rafaelandrepedro/LPI2-PI-Solar-Tracker/Projecto Integrador LPI 1 fase0_LL.pdf

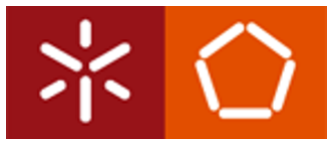
[picture p1: figure]

# PROJETO INTEGRADOR – LPI 1

# SOLAR TRACKER

## UNIVERSIDADE DO MINHO

## MIEEIC - 2020/2021

CONSTITUIÇÃO DO GRUPO:

- Gabriel Barbosa - A88300
- João Paulo - A88273
- Marco Barbosa - A88225
- Rafael Pedro - A88271
- Rodrigo Sousa - A88246
- Tiago Rodrigues - A93792

ORIENTADOR:

- Luís Filipe Castro Freitas Louro

DESCRIÇÃO PROJETO:

Depois de revisto, e aprovado pelo nosso professor orientador, o que se pretende com este projeto é desenvolver um sistema de um painel solar que seja capaz de acompanhar o ciclo solar de forma a retirar o maior proveito do mesmo. Este será capaz de se orientar segundo os dois eixos radiais (azimute e elevação) e terá como entrada a luminosidade exterior, orientando-se no sentido de maior intensidade.

Para o efeito recorrer-se-á a dois motores com alimentação DC e sensibilização para sabermos para que posição o nosso painel se deve deslocar.

Com este sistema espera-se obter um maior rendimento do painel solar, uma vez que este tenderá a apontar para a fonte solar com um ângulo de incidência próximo de zero, aproveitando assim toda a sua área de superfície.
