rafaelandrepedro/LPI2-PI-Solar-Tracker/base medidas (imagem)2.png

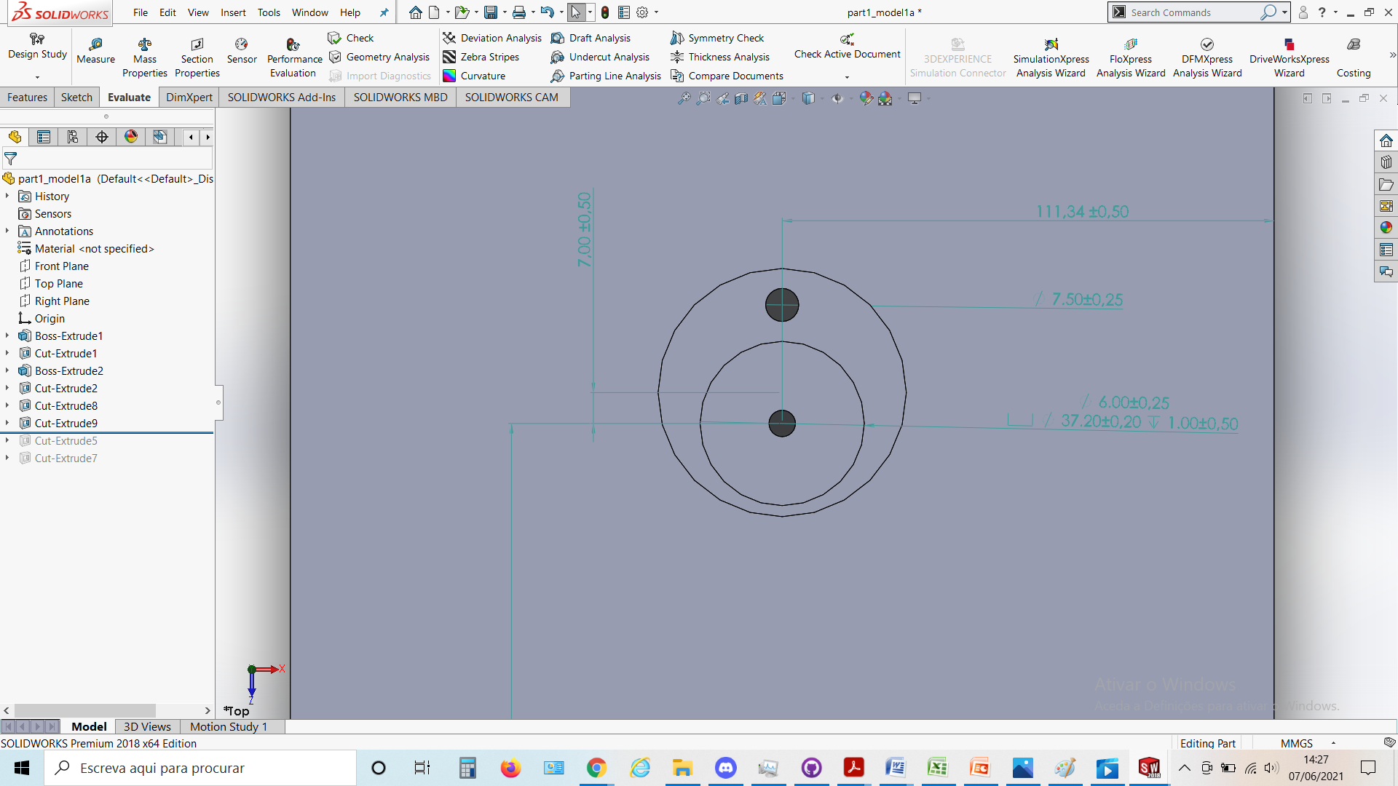
base medidas (imagem)2.png
