rafaelandrepedro/LPI2-PI-Solar-Tracker/base medidas (imagem)3.png

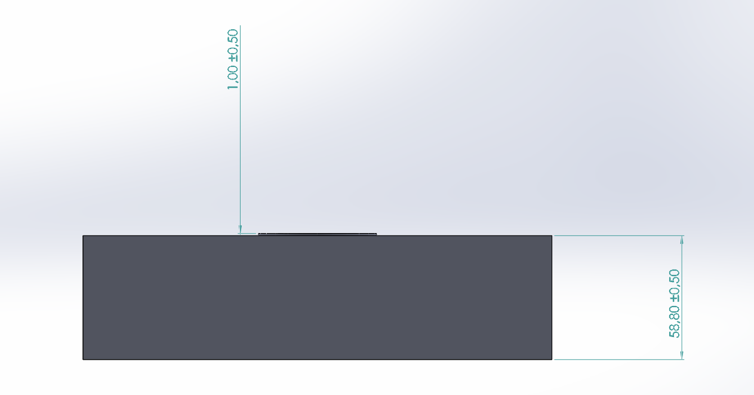
base medidas (imagem)3.png
