rafaelandrepedro/LPI2-PI-Solar-Tracker/base medidas (imagem)4.png

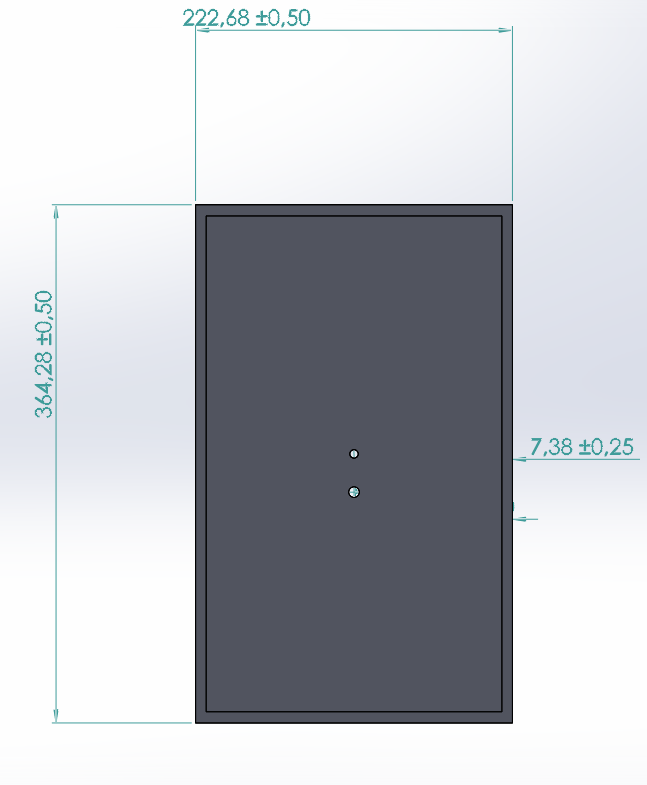
base medidas (imagem)4.png
