rafaelandrepedro/LPI2-PI-Solar-Tracker/base medidas (imagem)5.png

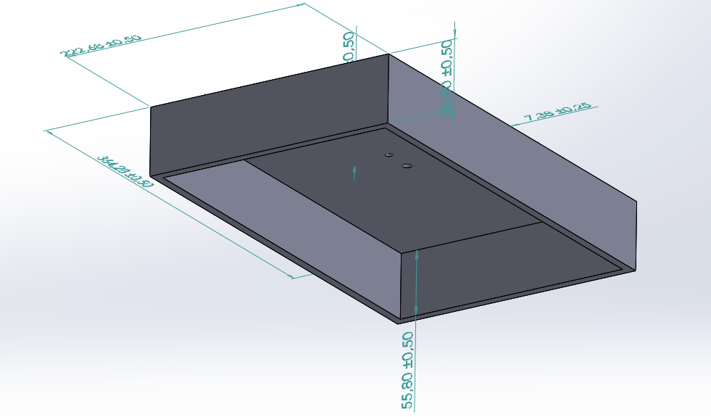
base medidas (imagem)5.png
