rafaelandrepedro/LPI2-PI-Solar-Tracker/base medidas (imagem).png

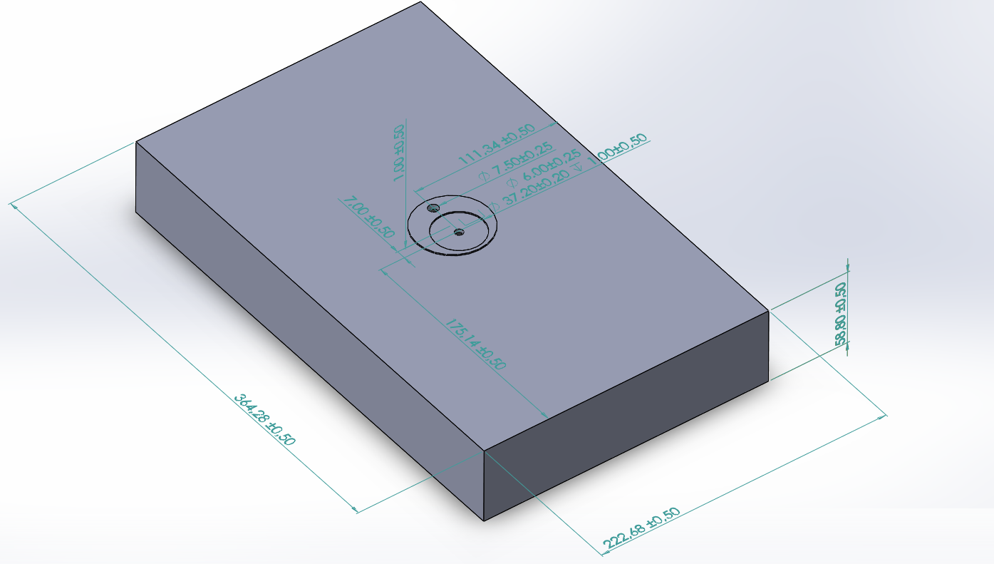
base medidas (imagem).png
