rafaelandrepedro/LPI2-PI-Solar-Tracker/fluxograma2.jpg

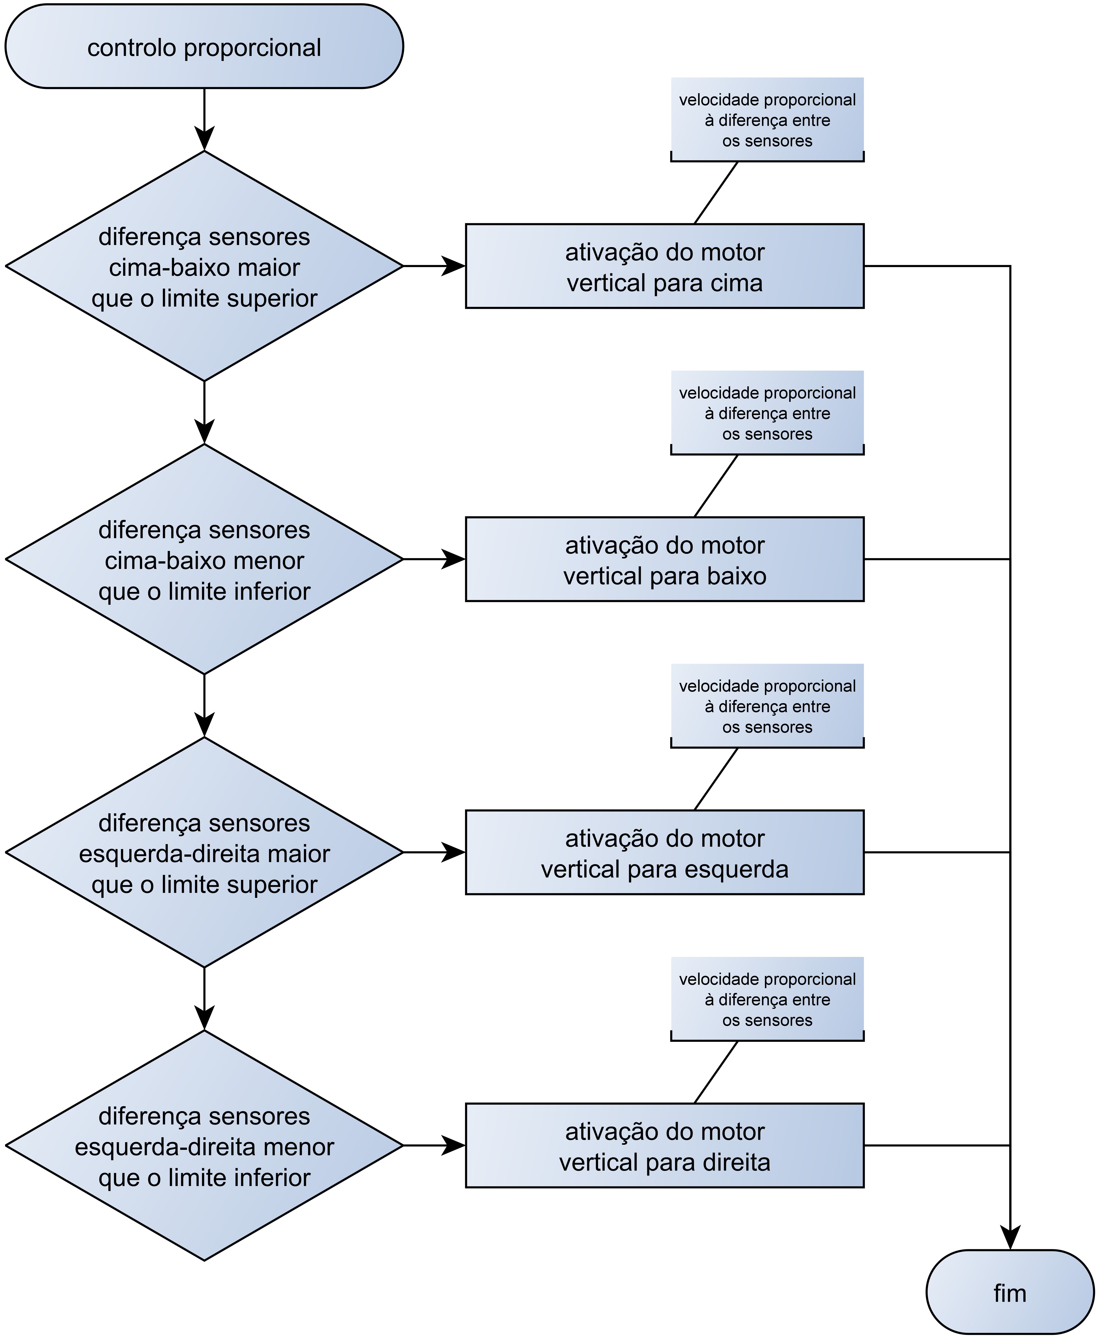
fluxograma2.jpg
