rafaelandrepedro/LPI2-PI-Solar-Tracker/fluxograma.jpg

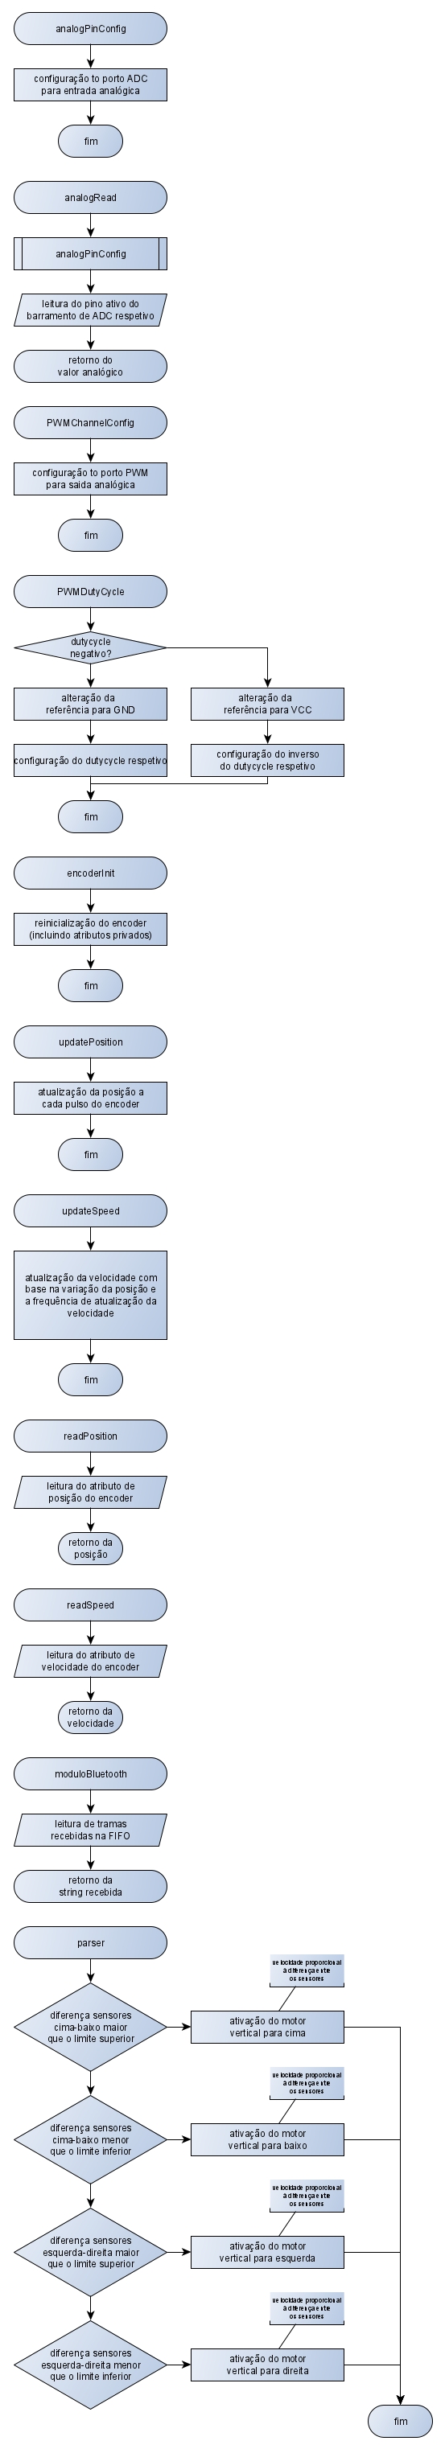
fluxograma.jpg
