rafaelandrepedro/LPI2-PI-Solar-Tracker/painel medidas (imagem)1.png

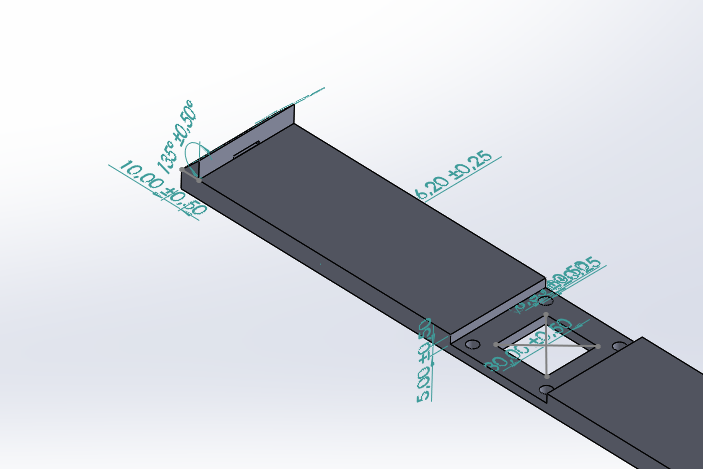
painel medidas (imagem)1.png
