rafaelandrepedro/LPI2-PI-Solar-Tracker/painel medidas (imagem)2.png

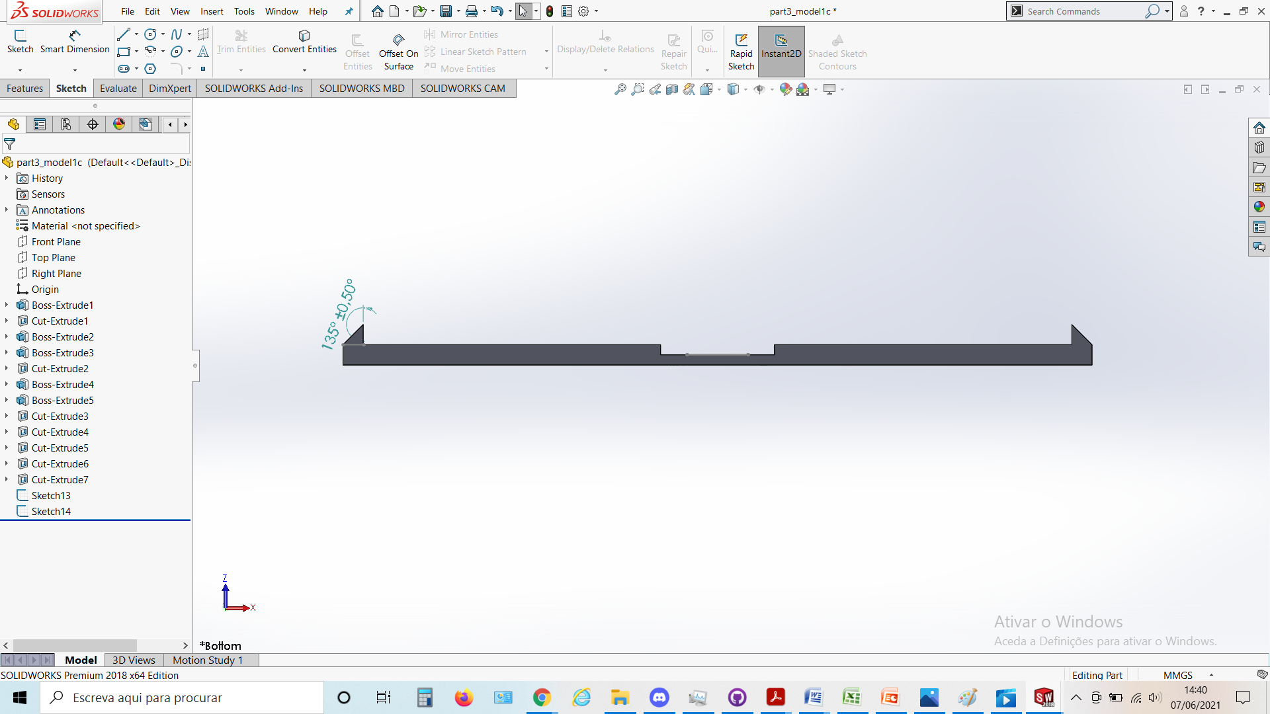
painel medidas (imagem)2.png
