rafaelandrepedro/LPI2-PI-Solar-Tracker/painel medidas (imagem)3.png

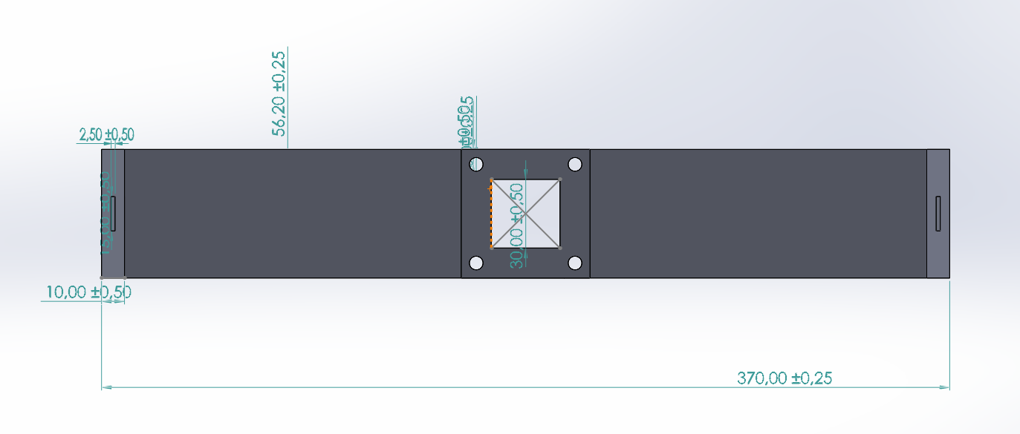
painel medidas (imagem)3.png
