rafaelandrepedro/LPI2-PI-Solar-Tracker/painel medidas (imagem)4.png

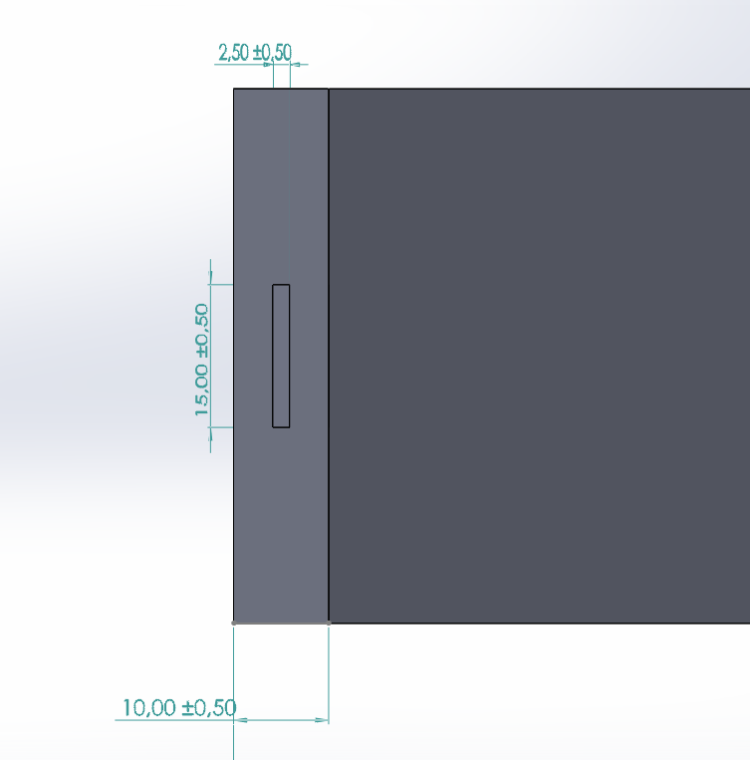
painel medidas (imagem)4.png
