rafaelandrepedro/LPI2-PI-Solar-Tracker/painel medidas (imagem)5.png

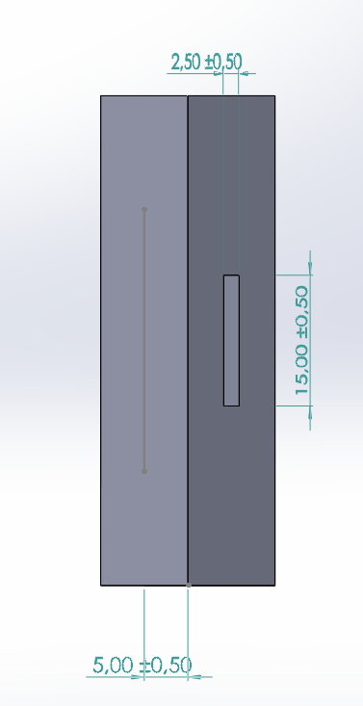
painel medidas (imagem)5.png
