rafaelandrepedro/LPI2-PI-Solar-Tracker/painel medidas (imagem)6.png

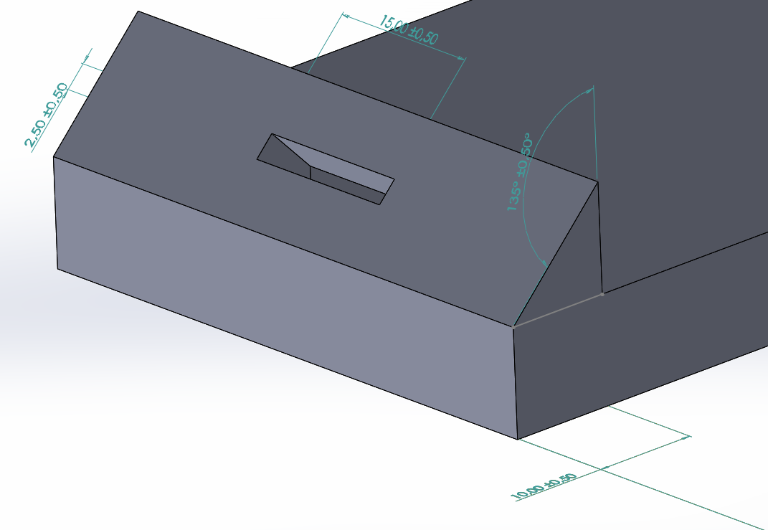
painel medidas (imagem)6.png
