rafaelandrepedro/LPI2-PI-Solar-Tracker/painel medidas (imagem)7.png

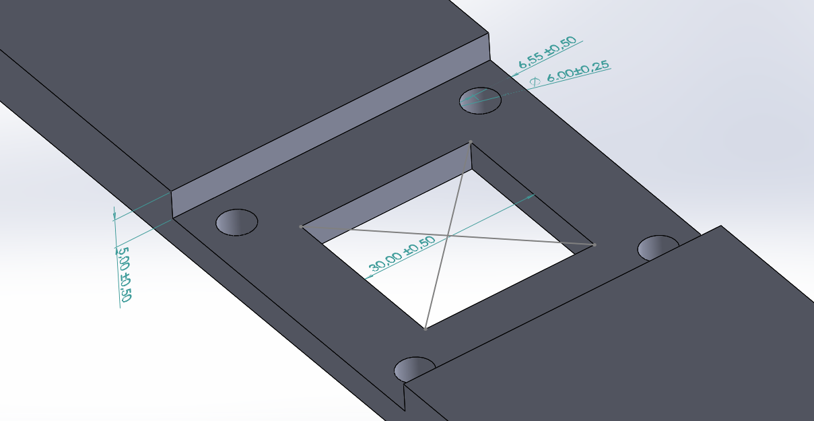
painel medidas (imagem)7.png
