rafaelandrepedro/LPI2-PI-Solar-Tracker/painel medidas (imagem)8.png

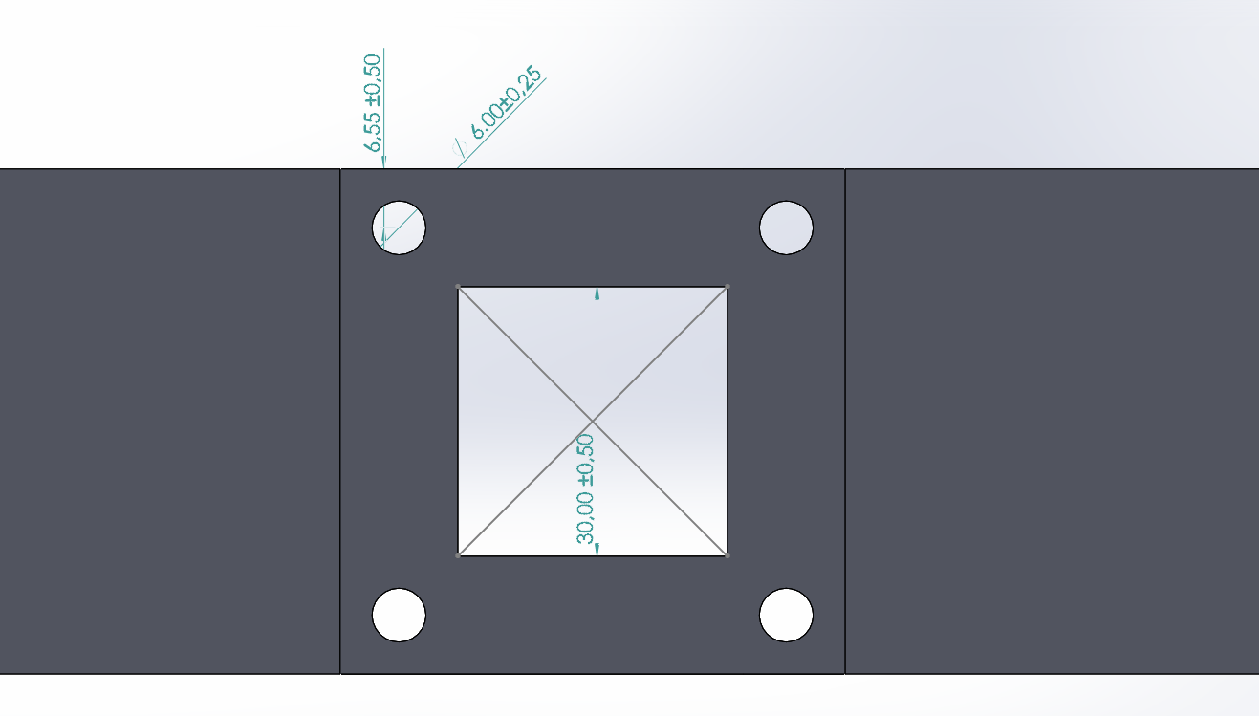
painel medidas (imagem)8.png
