rafaelandrepedro/LPI2-PI-Solar-Tracker/painel medidas (imagem)9.png

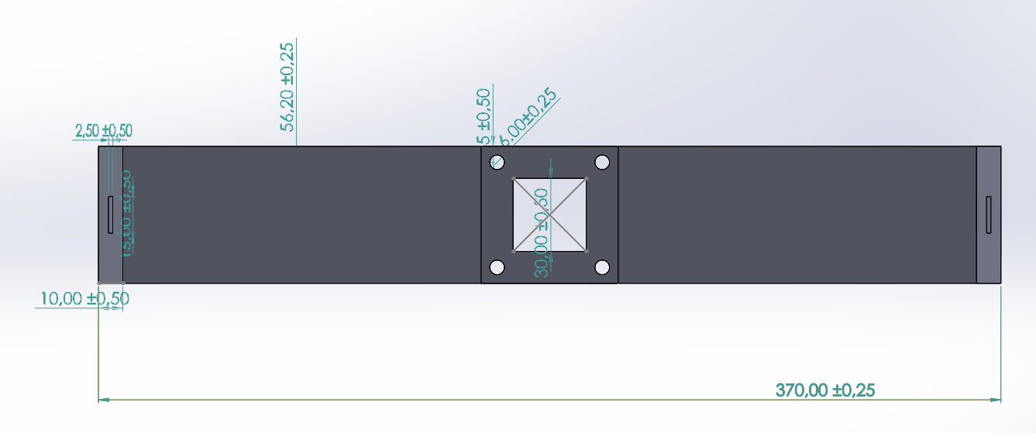
painel medidas (imagem)9.png
