rafaelandrepedro/LPI2-PI-Solar-Tracker/painel medidas (imagem)10.png

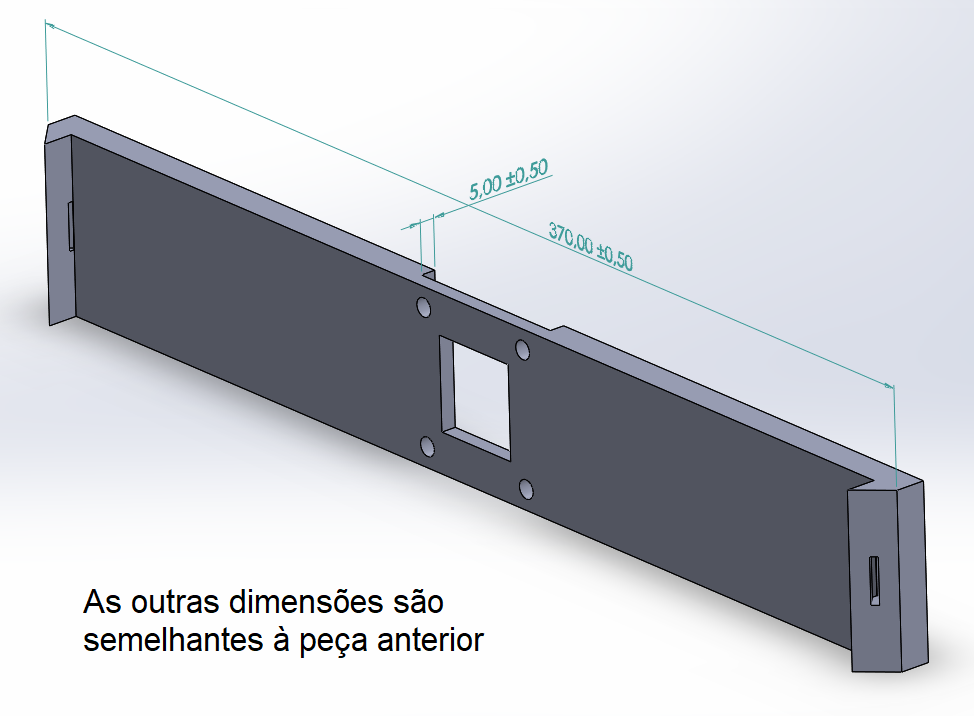
painel medidas (imagem)10.png
