rafaelandrepedro/LPI2-PI-Solar-Tracker/painel medidas (imagem)11.png

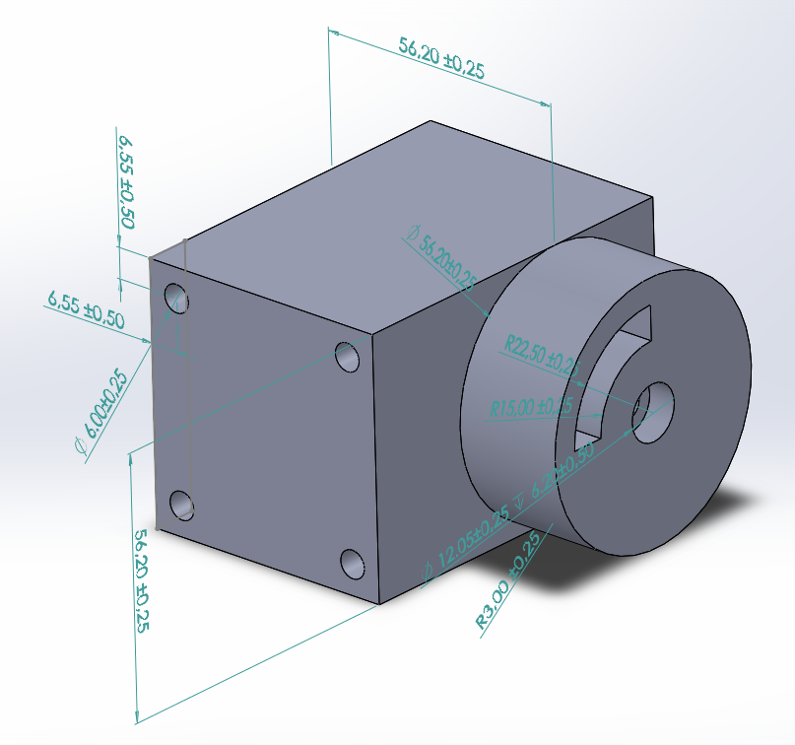
painel medidas (imagem)11.png
