rafaelandrepedro/LPI2-PI-Solar-Tracker/UML.bmp

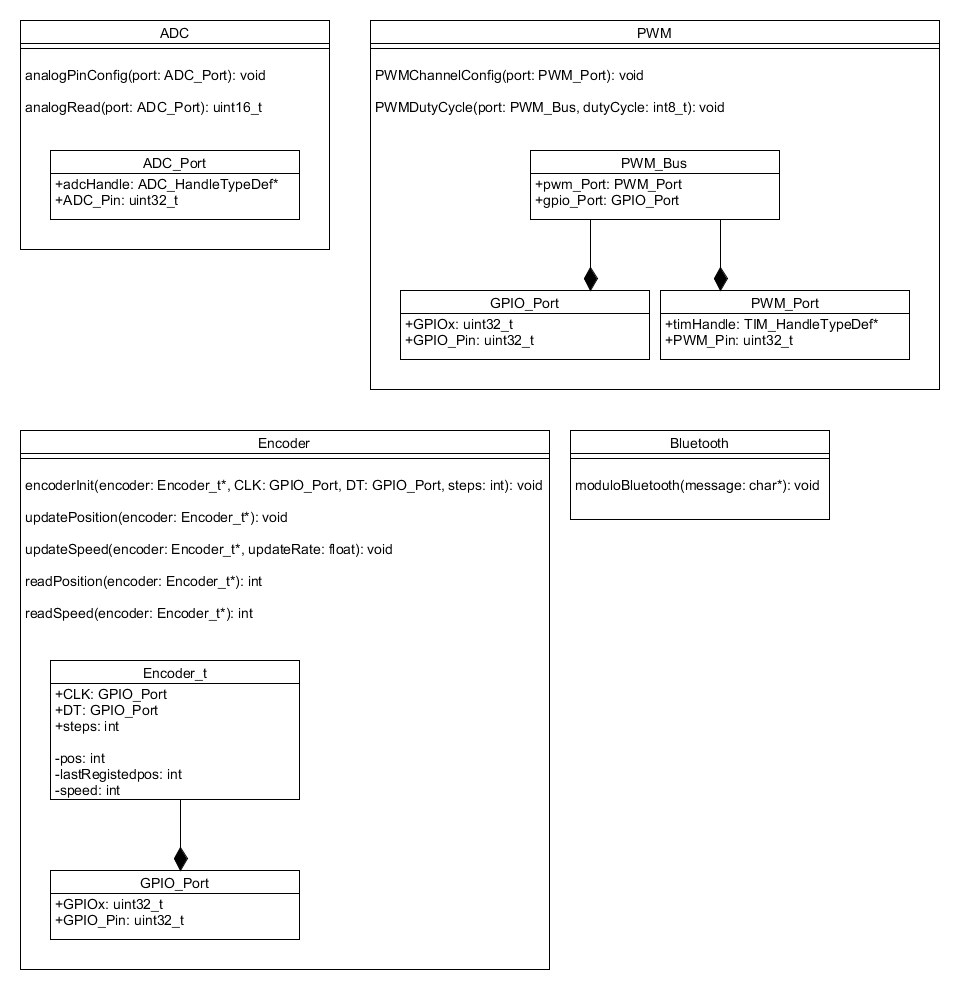
UML.bmp
