rafaelandrepedro/LPI2-PI-Solar-Tracker/UML.jpg

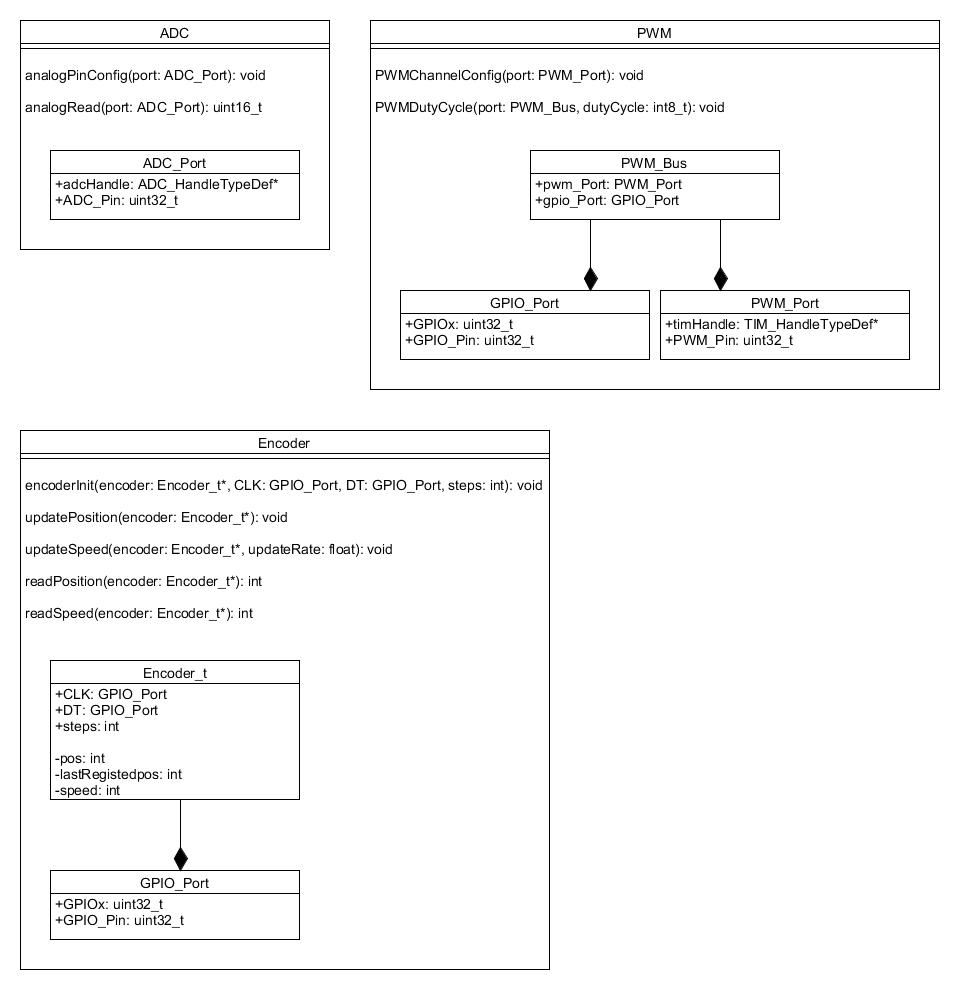
UML.jpg
