rafaelandrepedro/LPI2-PI-Solar-Tracker/modelo novo (com encoder)/Assem1.SLDASM

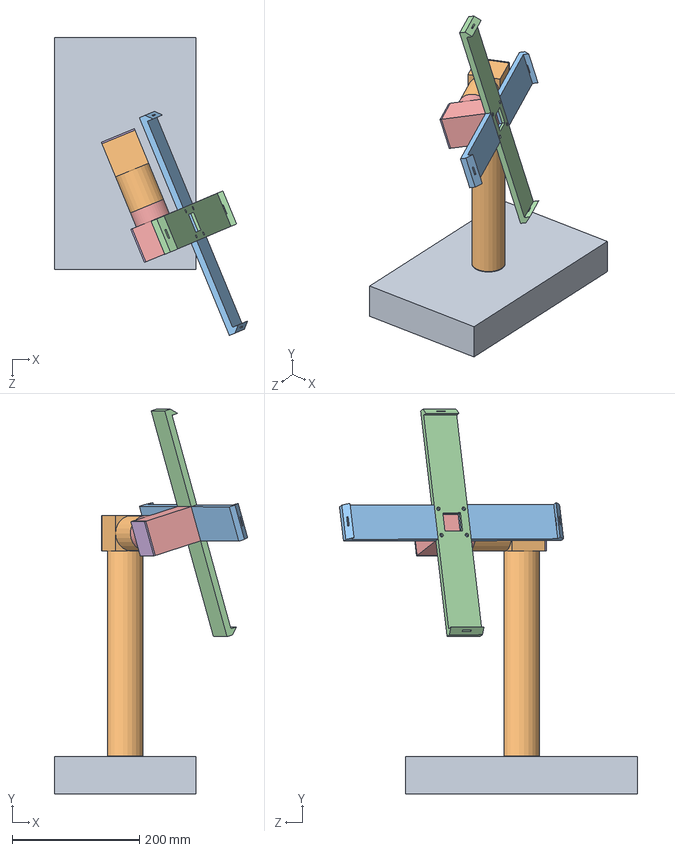
[picture p23: CAD file, 2021-06-18]
modelo novo (com encoder)/Assem1.SLDASM
303.5 x 604.5 x 468.0 mm
part1_model1b
part2_modela
part3_model1c
part3_model1d
part3_model2a
tampa (2) x 2
