rafaelandrepedro/LPI2-PI-Solar-Tracker/ficheiros LPI1/painel solar.SLDASM

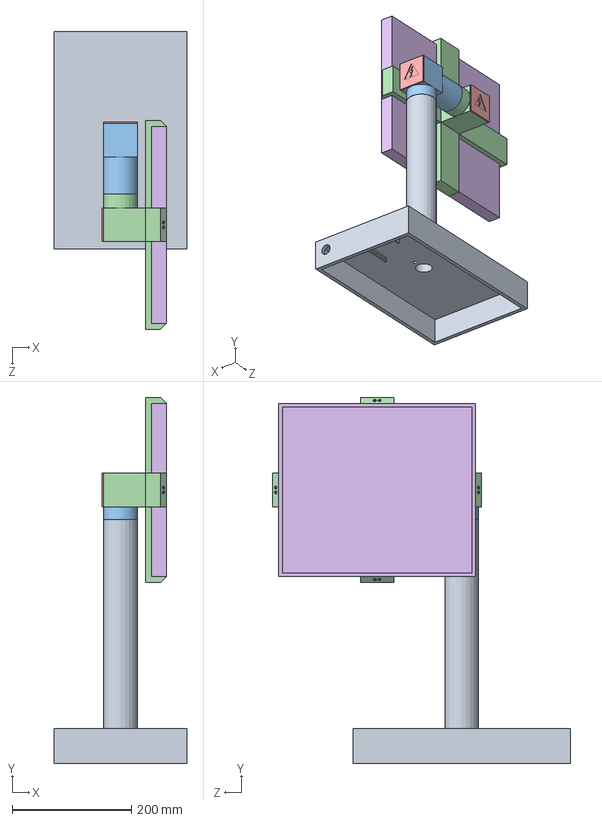
[picture p24: CAD file, 2021-06-05]
ficheiros LPI1/painel solar.SLDASM
222.7 x 613.4 x 498.6 mm
motor x 2
suporte1b
suporte2b
tampa eletrica x 2
PainelSolar
