rafaelandrepedro/LPI2-PI-Solar-Tracker/ficheiros LPI1/Aparelho.SLDASM

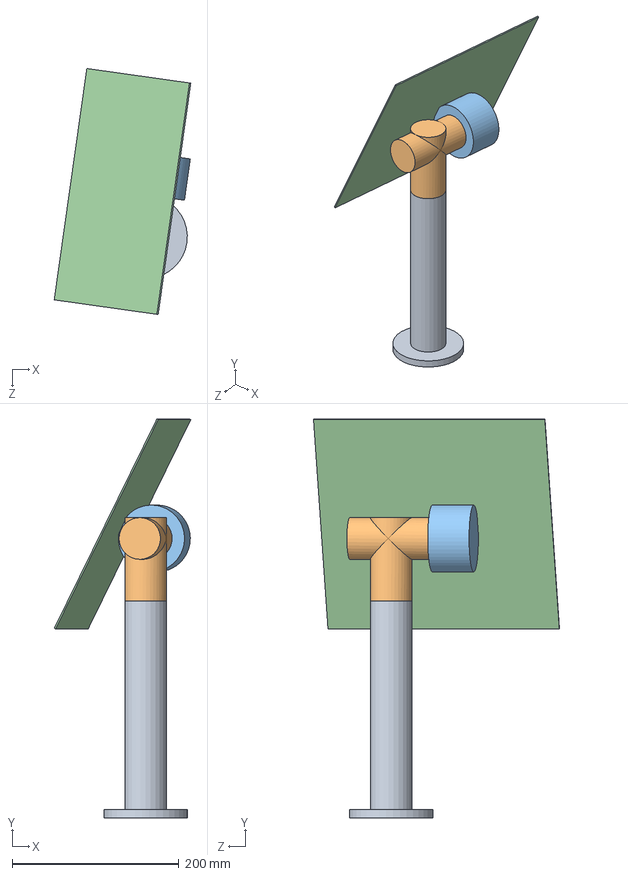
[picture p25: CAD file, 2021-06-05]
ficheiros LPI1/Aparelho.SLDASM
163.7 x 478.2 x 294.8 mm
Parte de baixo
Parte_meio
Parte_cima
PainelSolar
