rafaelandrepedro/LPI2-PI-Solar-Tracker/ficheiros LPI1/tabuleiro.SLDPRT

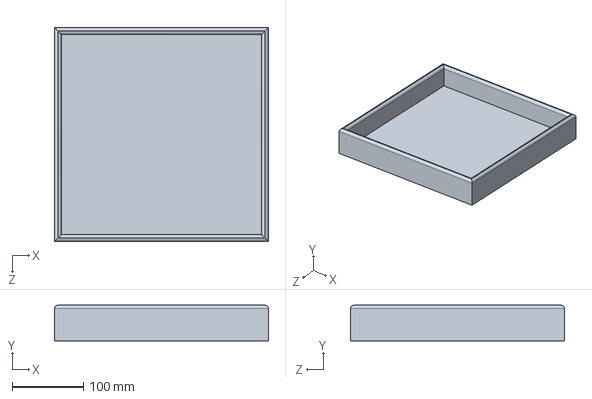
[picture p26: CAD file, 2021-06-05]
ficheiros LPI1/tabuleiro.SLDPRT
300.0 x 50.0 x 300.0 mm
