rafaelandrepedro/LPI2-PI-Solar-Tracker/modelo novo (com encoder)/part1_model1b.SLDPRT

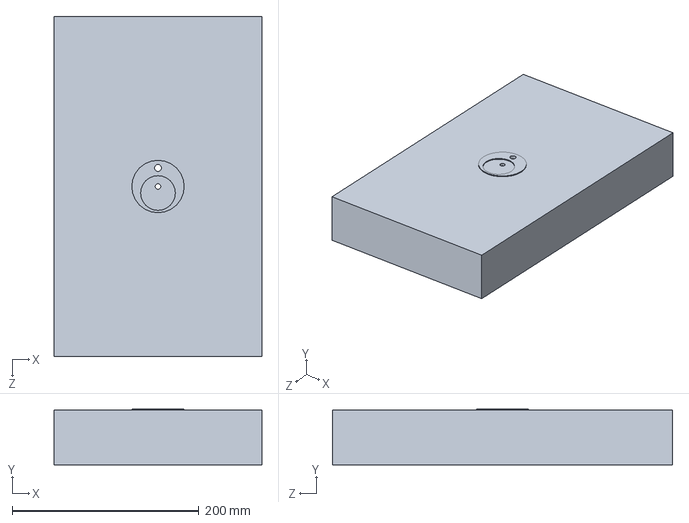
[picture p27: CAD file, 2021-06-18]
modelo novo (com encoder)/part1_model1b.SLDPRT
222.7 x 59.8 x 364.3 mm
