rafaelandrepedro/LPI2-PI-Solar-Tracker/modelo novo (com encoder)/pecas recortadas/base/base1.SLDPRT

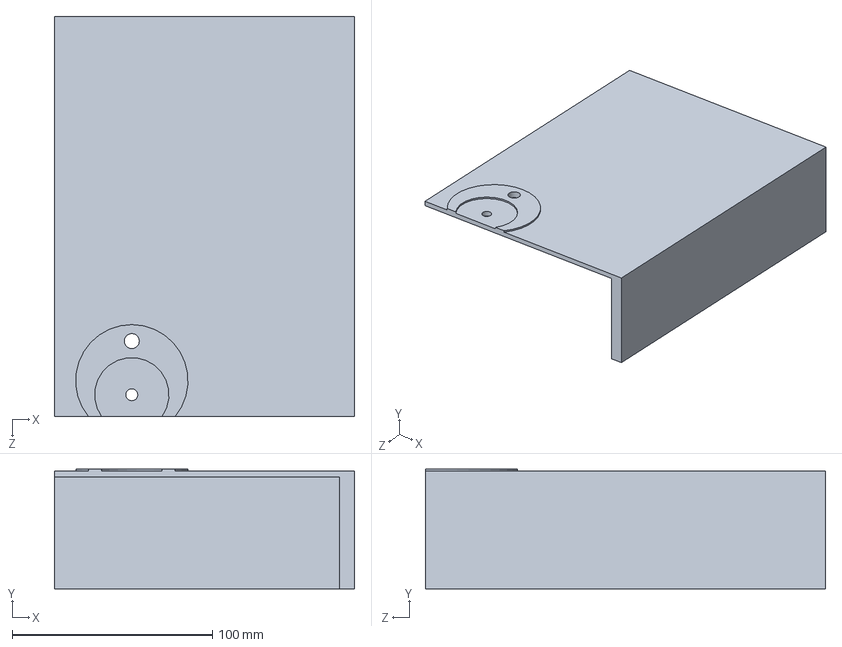
[picture p28: CAD file, 2021-06-14]
modelo novo (com encoder)/pecas recortadas/base/base1.SLDPRT
150.0 x 59.8 x 200.0 mm
