rafaelandrepedro/LPI2-PI-Solar-Tracker/modelo novo (com encoder)/pecas recortadas/cilindros/part2_modela_corte2.SLDPRT

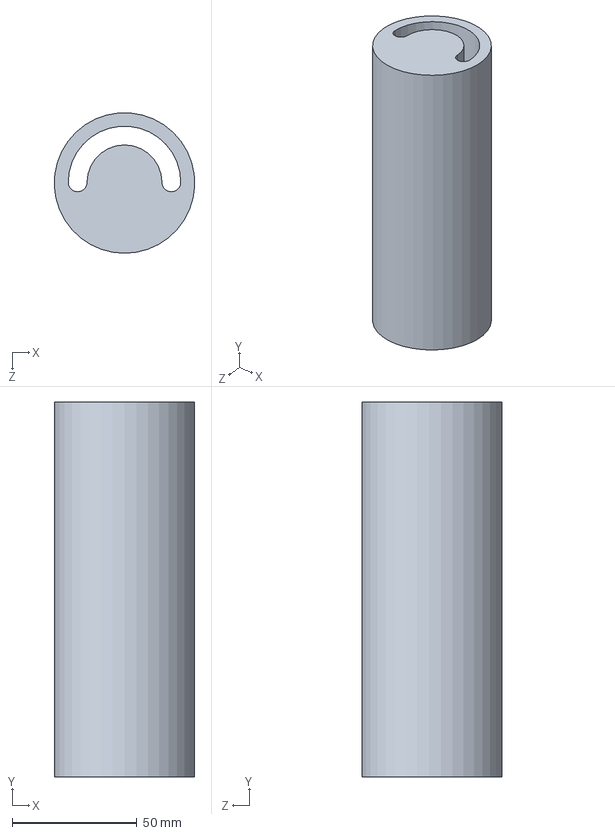
[picture p29: CAD file, 2021-06-10]
modelo novo (com encoder)/pecas recortadas/cilindros/part2_modela_corte2.SLDPRT
56.1 x 150.0 x 56.2 mm
