rafaelandrepedro/LPI2-PI-Solar-Tracker/modelo novo (com encoder)/pecas recortadas/pecas L/part3_model2a.SLDPRT

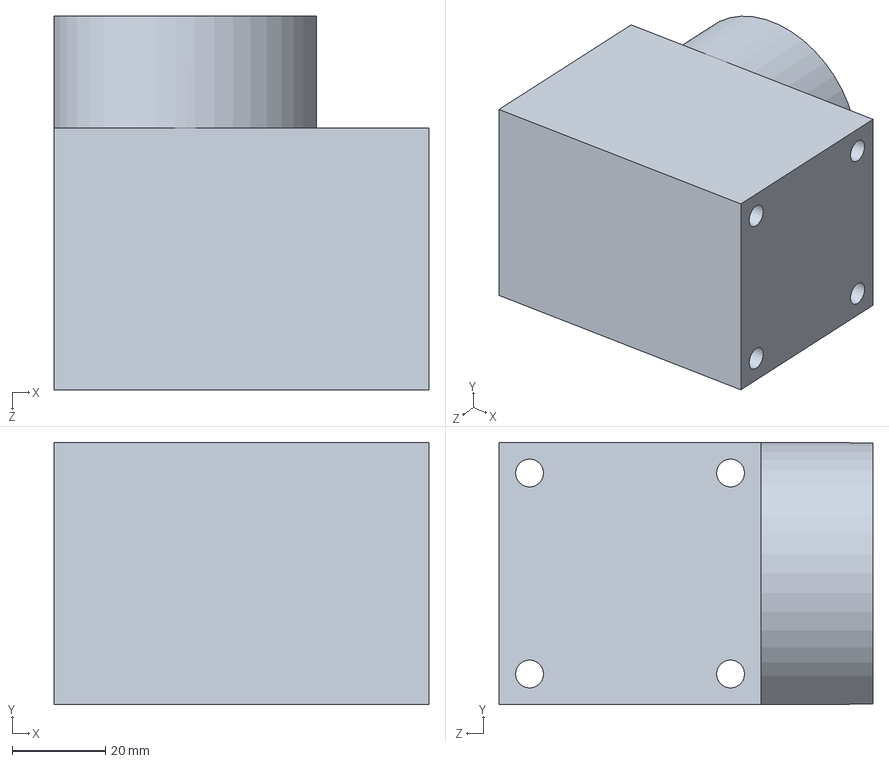
[picture p30: CAD file, 2021-06-10]
modelo novo (com encoder)/pecas recortadas/pecas L/part3_model2a.SLDPRT
80.3 x 56.2 x 80.2 mm
