rafaelandrepedro/LPI2-PI-Solar-Tracker/modelo novo (com encoder)/pecas recortadas/suporte painel/part3_model1_mid_corte (2x).SLDPRT

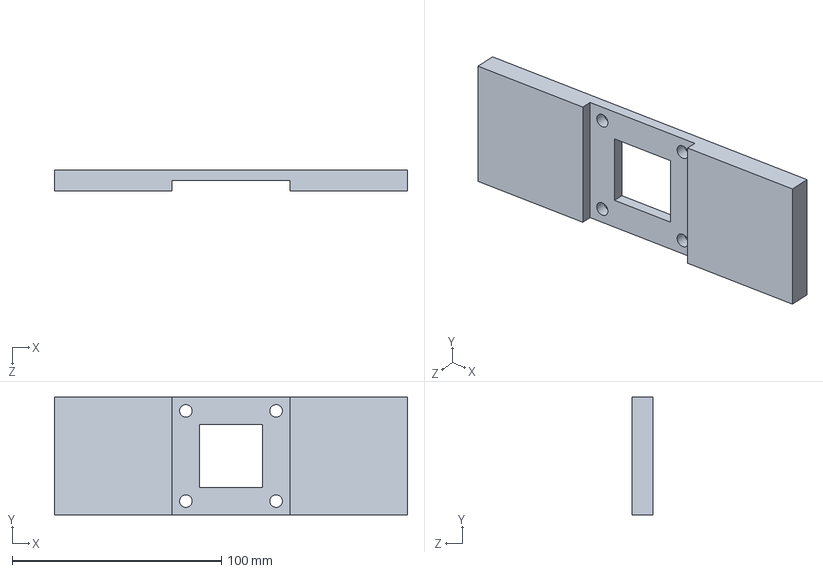
[picture p31: CAD file, 2021-06-10]
modelo novo (com encoder)/pecas recortadas/suporte painel/part3_model1_mid_corte (2x).SLDPRT
168.6 x 56.2 x 10.0 mm
