rafaelandrepedro/LPI2-PI-Solar-Tracker/modelo novo (com encoder)/pecas recortadas/tampa/tampa (2x).SLDPRT

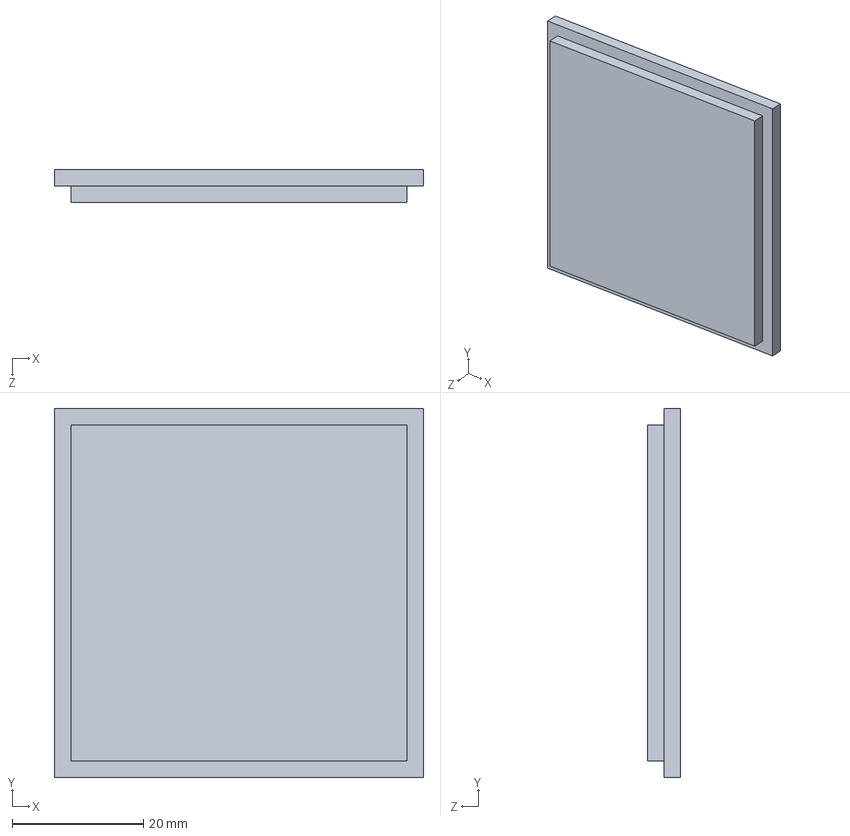
[picture p32: CAD file, 2021-06-05]
modelo novo (com encoder)/pecas recortadas/tampa/tampa (2x).SLDPRT
56.2 x 56.2 x 5.00 mm
