rafaelandrepedro/LPI2-PI-Solar-Tracker/pecas modelo antigo (sem encoder)/suporte1b.SLDPRT

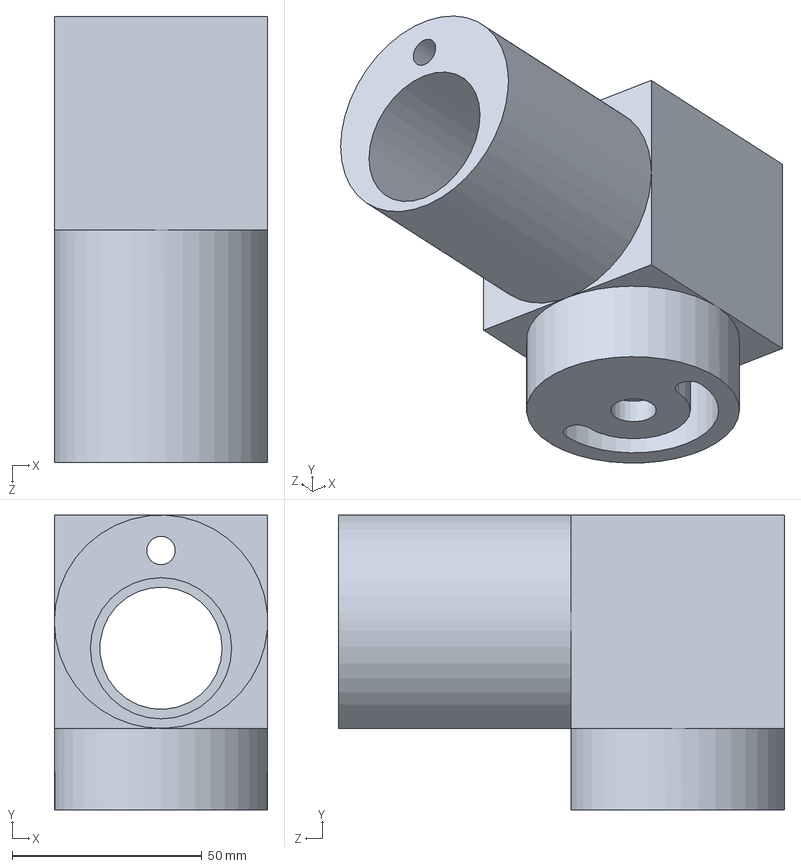
[picture p33: CAD file, 2021-06-05]
pecas modelo antigo (sem encoder)/suporte1b.SLDPRT
56.2 x 77.7 x 117.5 mm
