rafaelandrepedro/LPI2-PI-Solar-Tracker/ficheiros LPI1/Documentação auxiliar/Solid Works/motor.SLDPRT

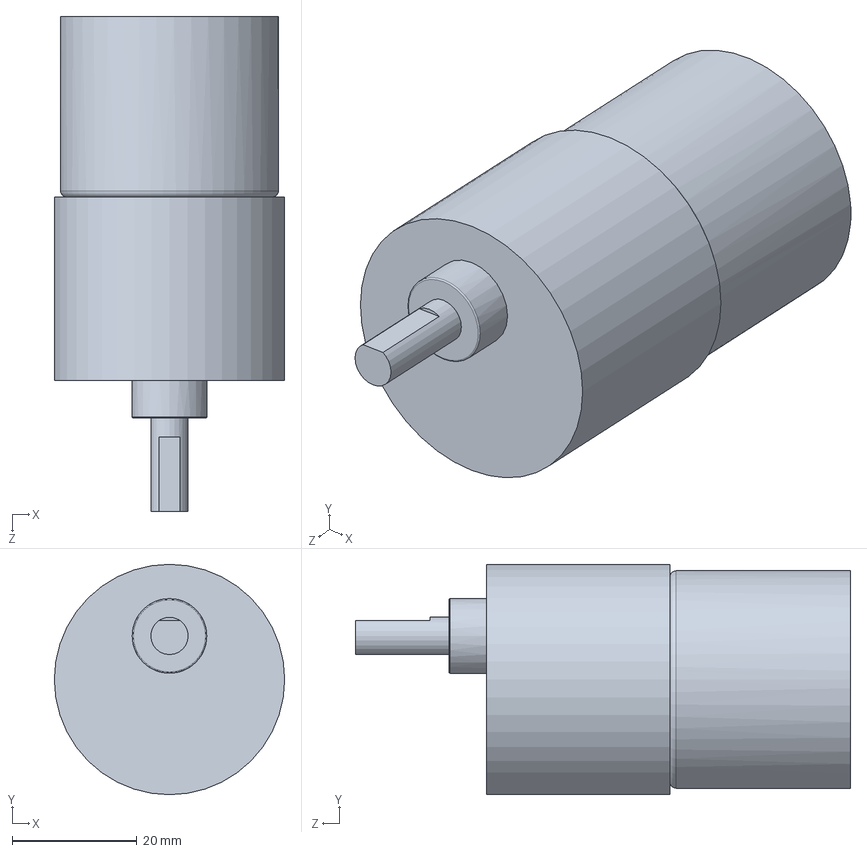
[picture p34: CAD file, 2021-06-05]
ficheiros LPI1/Documentação auxiliar/Solid Works/motor.SLDPRT
37.0 x 37.0 x 79.5 mm
