rafaelandrepedro/LPI2-PI-Solar-Tracker/ficheiros LPI1/peça curva.SLDPRT

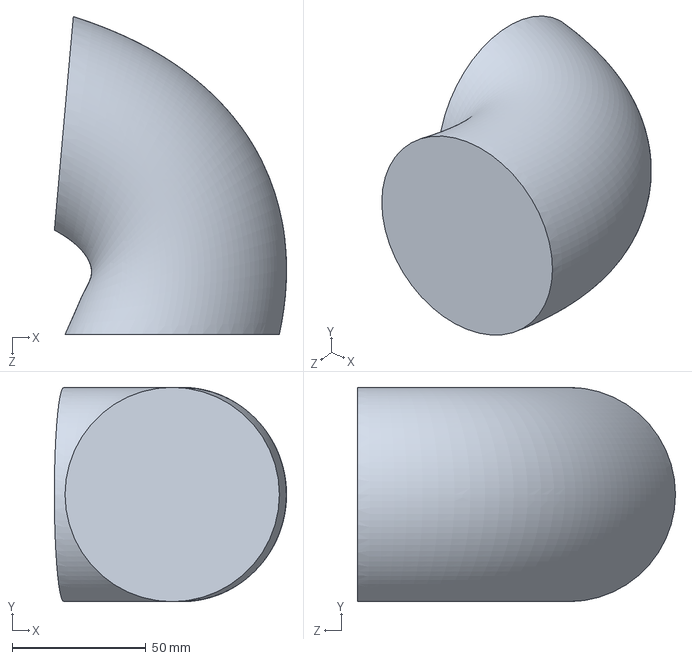
[picture p35: CAD file, 2021-06-05]
ficheiros LPI1/peça curva.SLDPRT
86.7 x 80.0 x 118.7 mm
