rafaelandrepedro/LPI2-PI-Solar-Tracker/modelo novo (com encoder)/pecas recortadas/base/base4.SLDPRT

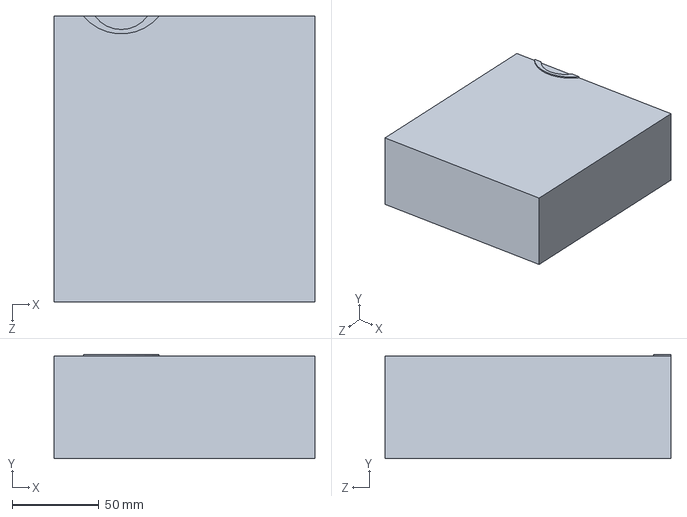
[picture p36: CAD file, 2021-06-14]
modelo novo (com encoder)/pecas recortadas/base/base4.SLDPRT
150.0 x 59.8 x 164.3 mm
