rafaelandrepedro/LPI2-PI-Solar-Tracker/modelo novo (com encoder)/pecas recortadas/cilindros/part2_modela_corte1.SLDPRT

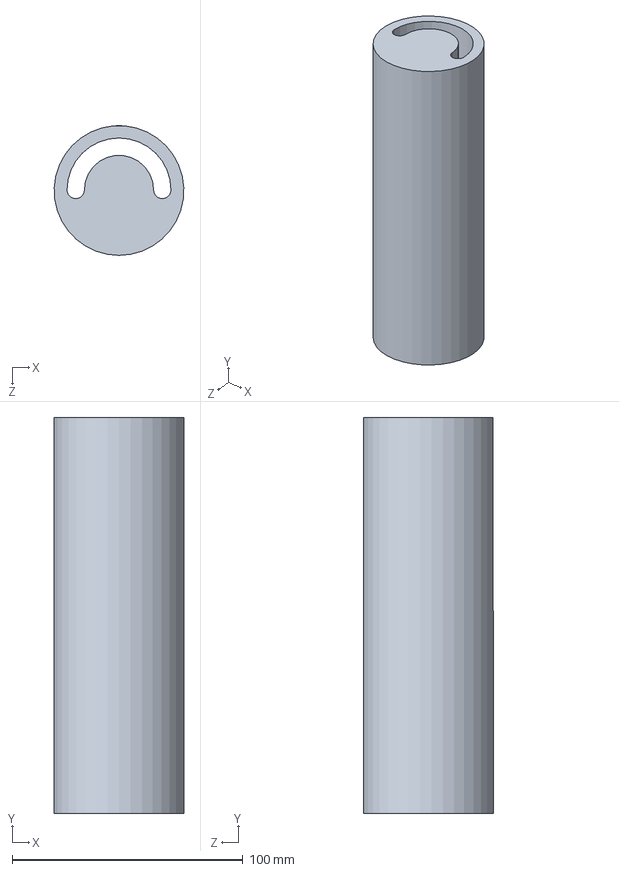
[picture p37: CAD file, 2021-06-10]
modelo novo (com encoder)/pecas recortadas/cilindros/part2_modela_corte1.SLDPRT
56.1 x 171.5 x 56.2 mm
