rafaelandrepedro/LPI2-PI-Solar-Tracker/modelo novo (com encoder)/pecas recortadas/pecas L/part2_modela_corte3.SLDPRT

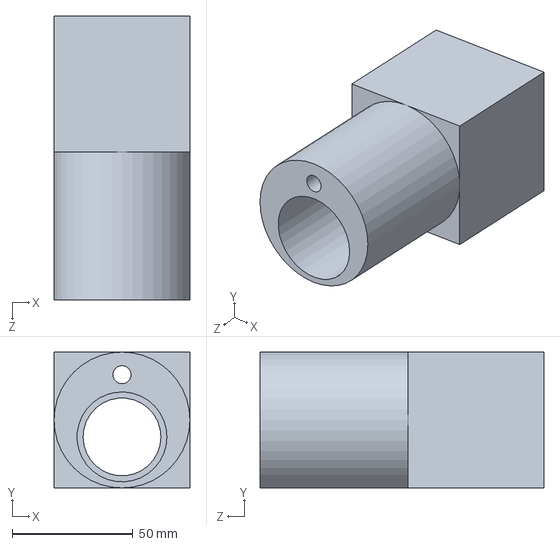
[picture p38: CAD file, 2021-06-10]
modelo novo (com encoder)/pecas recortadas/pecas L/part2_modela_corte3.SLDPRT
56.2 x 56.2 x 117.5 mm
