rafaelandrepedro/LPI2-PI-Solar-Tracker/pecas modelo antigo (sem encoder)/suporte2b.SLDPRT

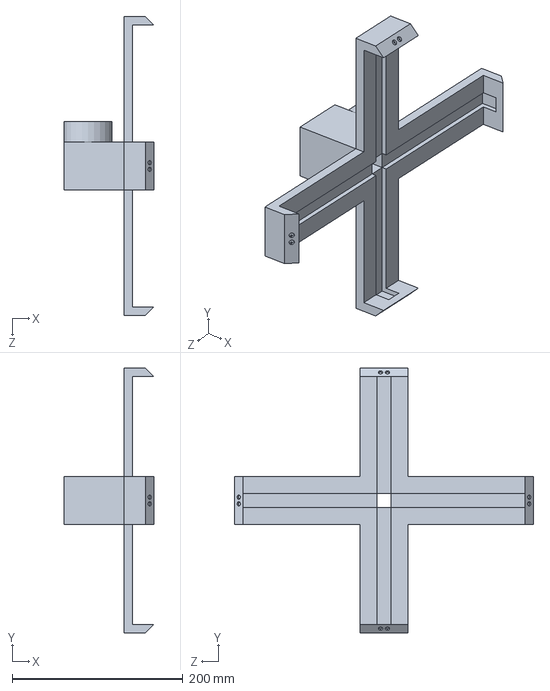
[picture p40: CAD file, 2021-06-05]
pecas modelo antigo (sem encoder)/suporte2b.SLDPRT
105.3 x 310.0 x 350.0 mm
