rafaelandrepedro/LPI2-PI-Solar-Tracker/ficheiros LPI1/Documentação auxiliar/Solid Works/Part1.SLDPRT

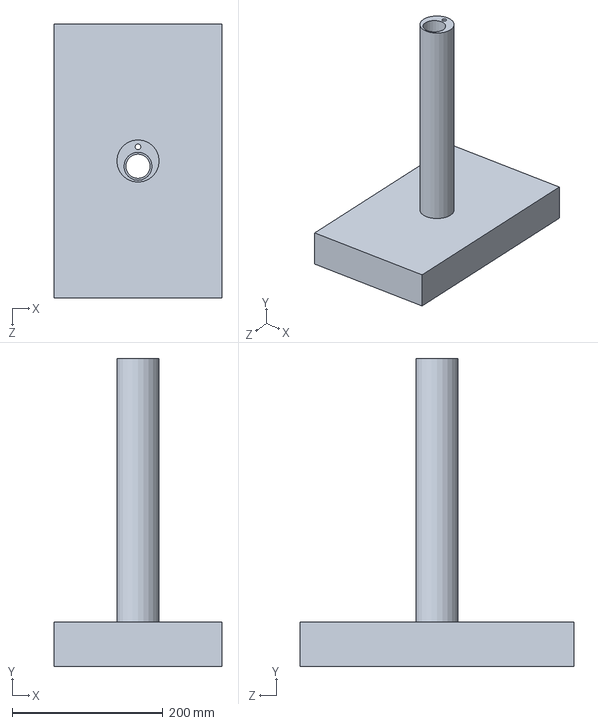
[picture p41: CAD file, 2021-06-05]
ficheiros LPI1/Documentação auxiliar/Solid Works/Part1.SLDPRT
222.7 x 408.8 x 364.3 mm
