rafaelandrepedro/LPI2-PI-Solar-Tracker/modelo novo (com encoder)/part3_model1c.SLDPRT

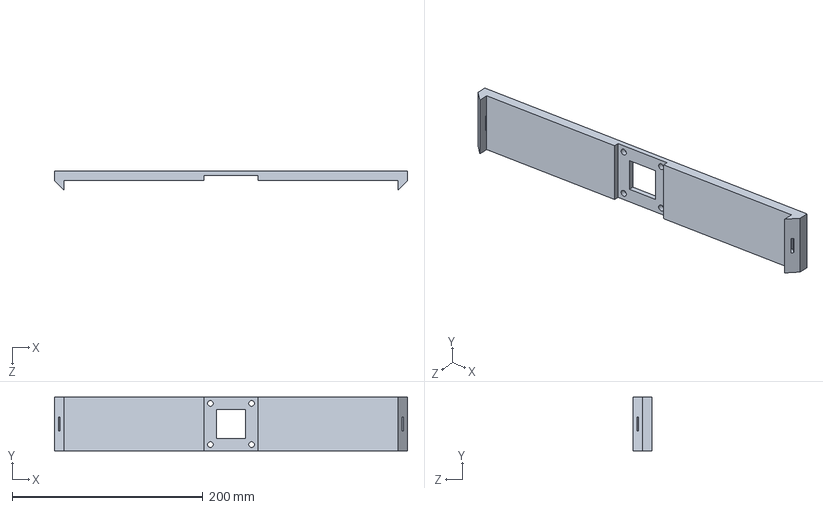
[picture p42: CAD file, 2021-06-18]
modelo novo (com encoder)/part3_model1c.SLDPRT
370.0 x 56.2 x 20.0 mm
