rafaelandrepedro/LPI2-PI-Solar-Tracker/modelo novo (com encoder)/pecas recortadas/base/base2.SLDPRT

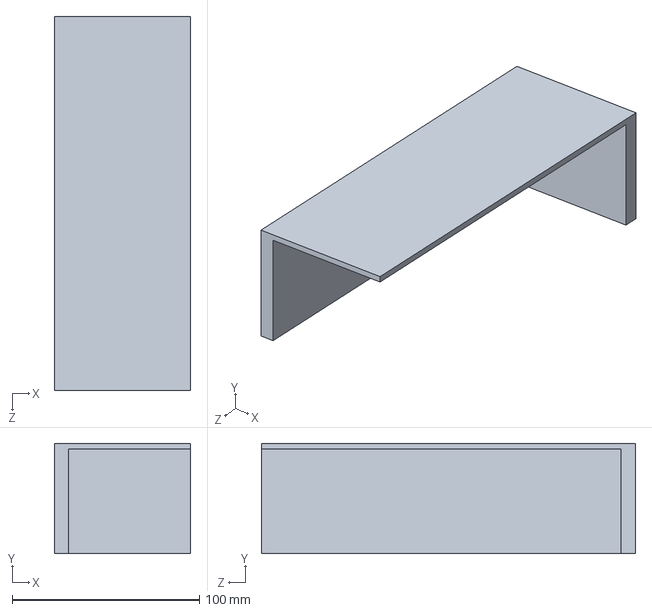
[picture p43: CAD file, 2021-06-14]
modelo novo (com encoder)/pecas recortadas/base/base2.SLDPRT
72.7 x 58.8 x 200.0 mm
