rafaelandrepedro/LPI2-PI-Solar-Tracker/modelo novo (com encoder)/pecas recortadas/suporte painel/part3_model1_top_corte1 (2x).SLDPRT

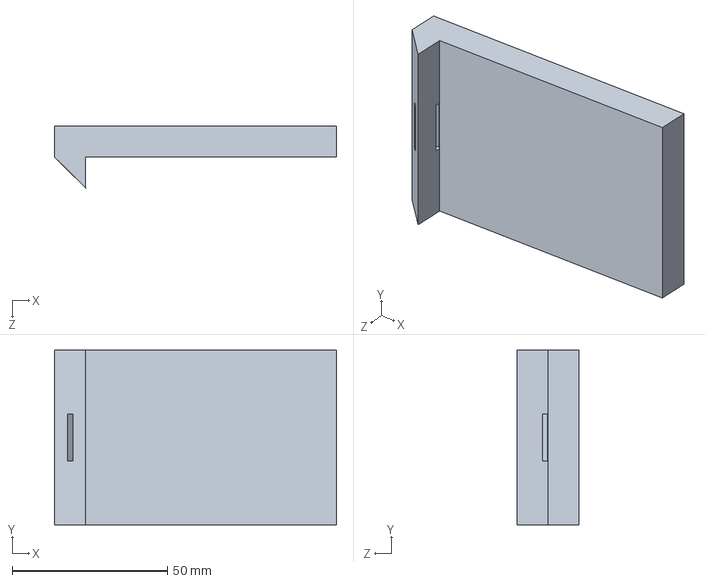
[picture p44: CAD file, 2021-06-10]
modelo novo (com encoder)/pecas recortadas/suporte painel/part3_model1_top_corte1 (2x).SLDPRT
90.7 x 56.2 x 20.0 mm
