rafaelandrepedro/LPI2-PI-Solar-Tracker/pecas modelo antigo (sem encoder)/Part3.SLDPRT

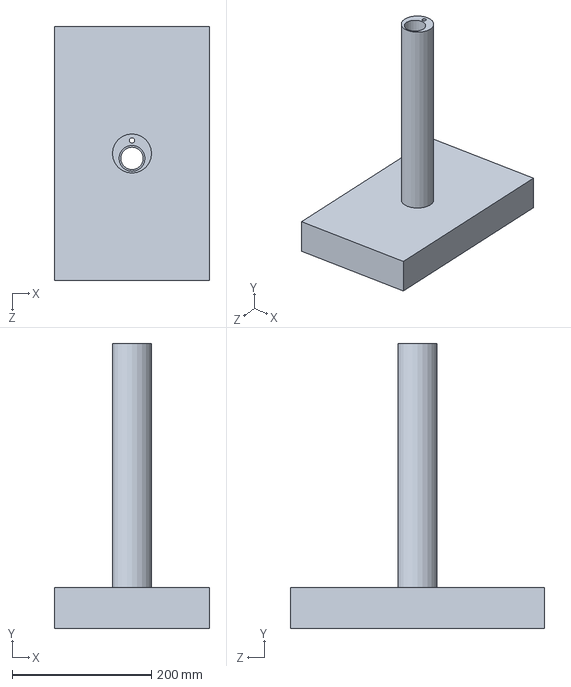
[picture p45: CAD file, 2021-06-05]
pecas modelo antigo (sem encoder)/Part3.SLDPRT
222.7 x 408.8 x 364.3 mm
