rafaelandrepedro/LPI2-PI-Solar-Tracker/ficheiros LPI1/cubo_teste.SLDPRT

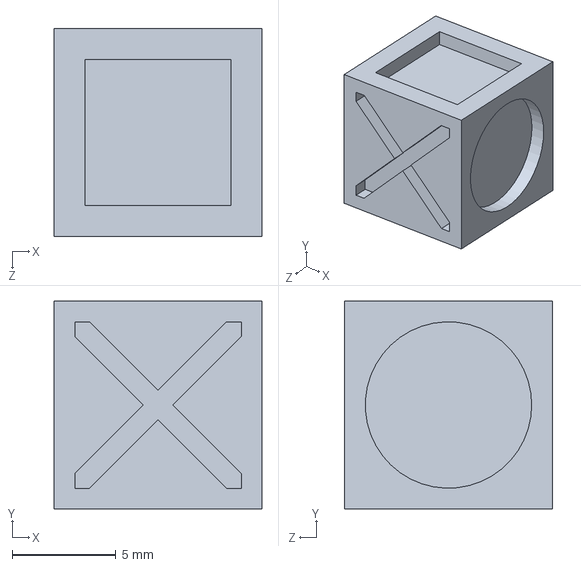
[picture p46: CAD file, 2021-06-05]
ficheiros LPI1/cubo_teste.SLDPRT
10.0 x 10.0 x 10.0 mm
