rafaelandrepedro/LPI2-PI-Solar-Tracker/modelo novo (com encoder)/pecas recortadas/base/base3.SLDPRT

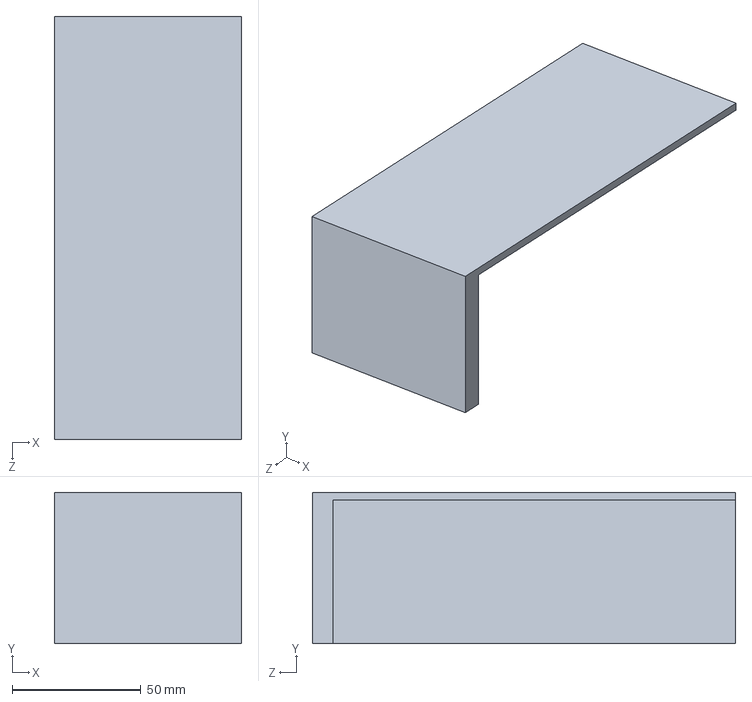
[picture p47: CAD file, 2021-06-14]
modelo novo (com encoder)/pecas recortadas/base/base3.SLDPRT
72.7 x 58.8 x 164.3 mm
