rafaelandrepedro/LPI2-PI-Solar-Tracker/ficheiros LPI1/suporte1.SLDPRT

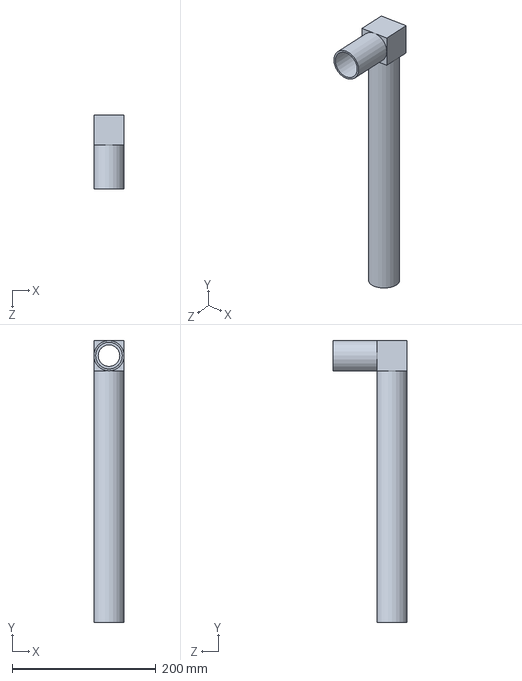
[picture p48: CAD file, 2021-06-05]
ficheiros LPI1/suporte1.SLDPRT
42.2 x 392.2 x 103.5 mm
