rafaelandrepedro/LPI2-PI-Solar-Tracker/modelo novo (com encoder)/part2_modela.SLDPRT

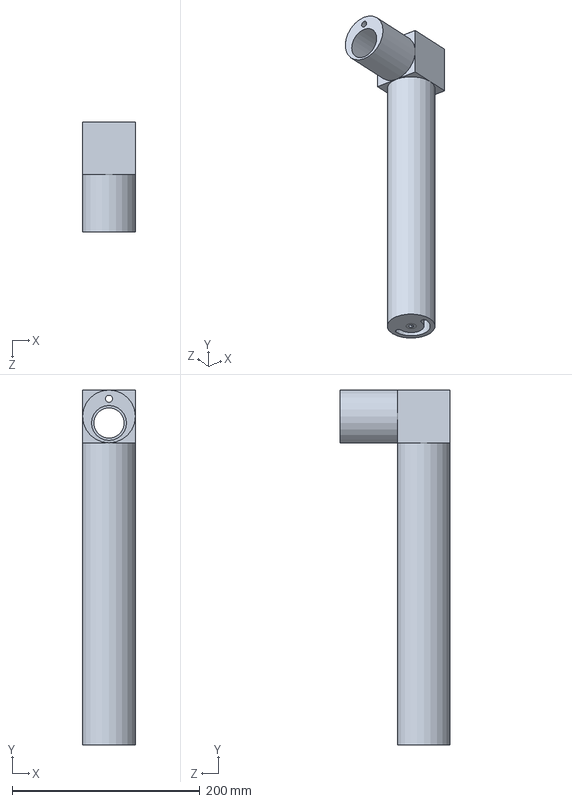
[picture p49: CAD file, 2021-06-18]
modelo novo (com encoder)/part2_modela.SLDPRT
56.2 x 377.7 x 117.5 mm
