rafaelandrepedro/LPI2-PI-Solar-Tracker/ficheiros LPI1/Documentação auxiliar/Solid Works/tampa eletrica.SLDPRT

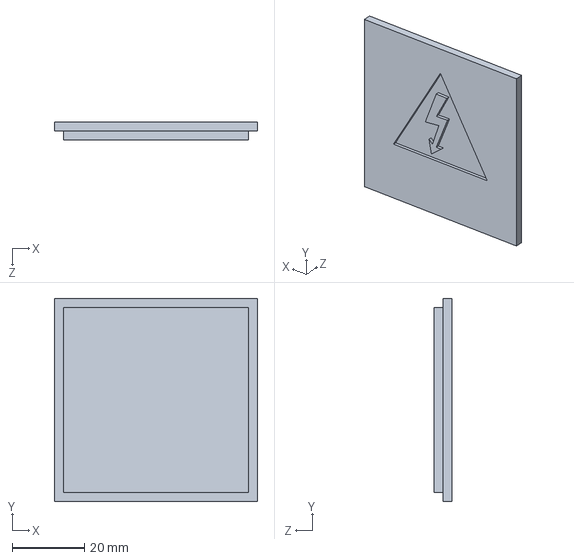
[picture p50: CAD file, 2021-06-05]
ficheiros LPI1/Documentação auxiliar/Solid Works/tampa eletrica.SLDPRT
56.2 x 56.2 x 5.00 mm
