rafaelandrepedro/LPI2-PI-Solar-Tracker/ficheiros LPI1/Parte de baixo.SLDPRT

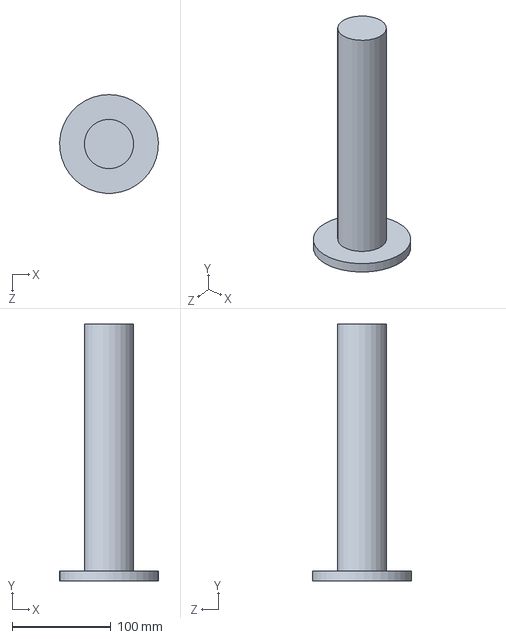
[picture p51: CAD file, 2021-06-05]
ficheiros LPI1/Parte de baixo.SLDPRT
99.9 x 260.0 x 100.0 mm
