rafaelandrepedro/LPI2-PI-Solar-Tracker/ficheiros LPI1/lpi2_1.SLDPRT

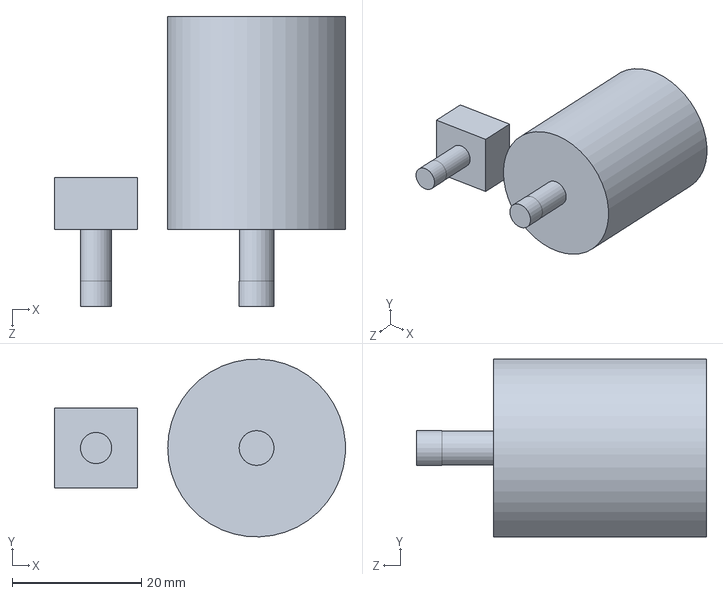
[picture p52: CAD file, 2021-06-05]
ficheiros LPI1/lpi2_1.SLDPRT
45.1 x 27.5 x 45.0 mm
