rafaelandrepedro/LPI2-PI-Solar-Tracker/ficheiros LPI1/lpi2_2.SLDPRT

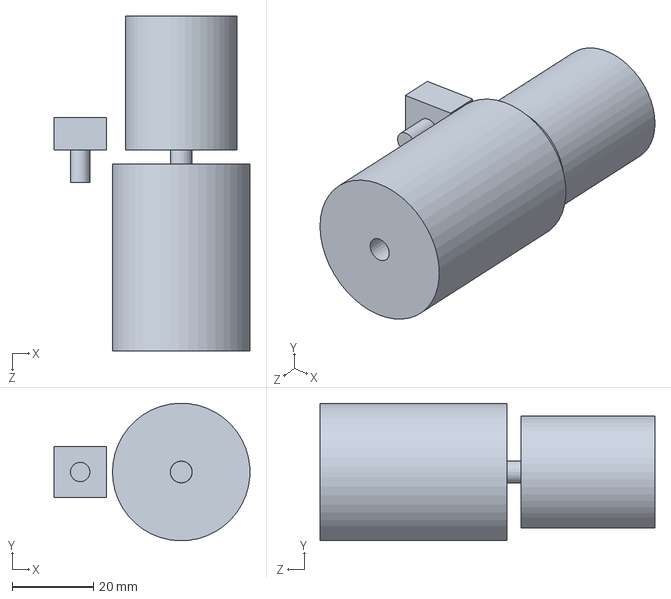
[picture p53: CAD file, 2021-06-05]
ficheiros LPI1/lpi2_2.SLDPRT
48.2 x 33.8 x 82.4 mm
