rafaelandrepedro/LPI2-PI-Solar-Tracker/ficheiros LPI1/Parte_cima.SLDPRT

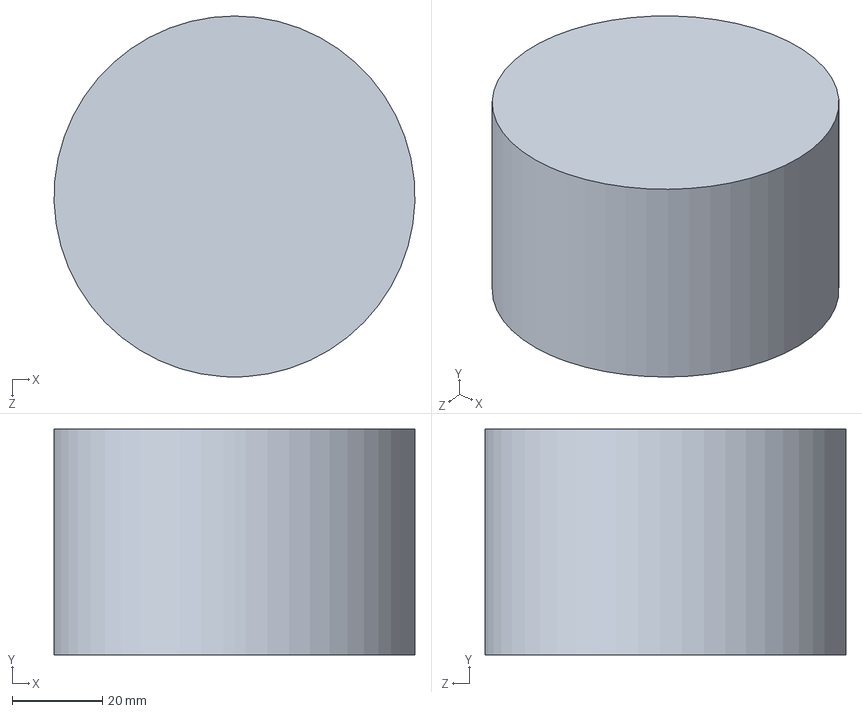
[picture p54: CAD file, 2021-06-05]
ficheiros LPI1/Parte_cima.SLDPRT
80.0 x 50.0 x 80.0 mm
