rafaelandrepedro/LPI2-PI-Solar-Tracker/ficheiros LPI1/Part2.SLDPRT

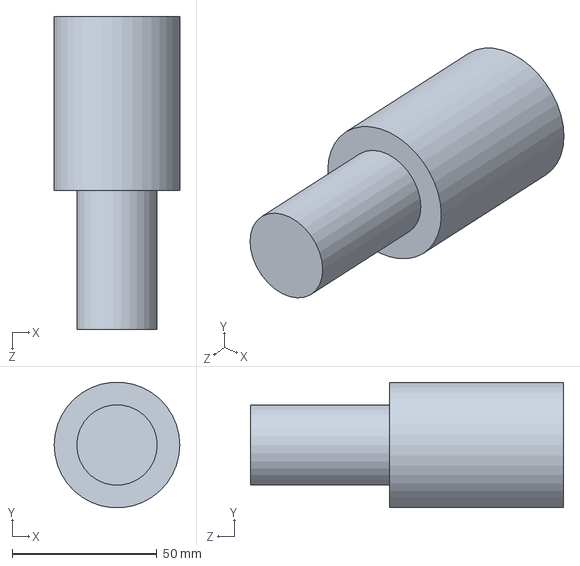
[picture p55: CAD file, 2021-06-05]
ficheiros LPI1/Part2.SLDPRT
43.4 x 43.2 x 108.0 mm
