rafaelandrepedro/LPI2-PI-Solar-Tracker/ficheiros LPI1/Parte_meio.SLDPRT

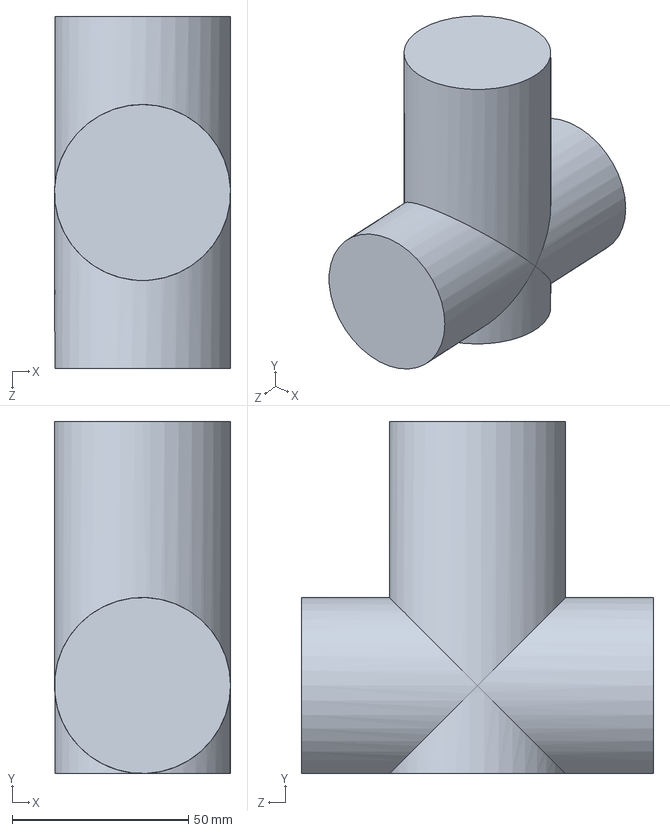
[picture p56: CAD file, 2021-06-05]
ficheiros LPI1/Parte_meio.SLDPRT
50.0 x 100.0 x 100.0 mm
