rafaelandrepedro/LPI2-PI-Solar-Tracker/ficheiros LPI1/esfera.SLDPRT

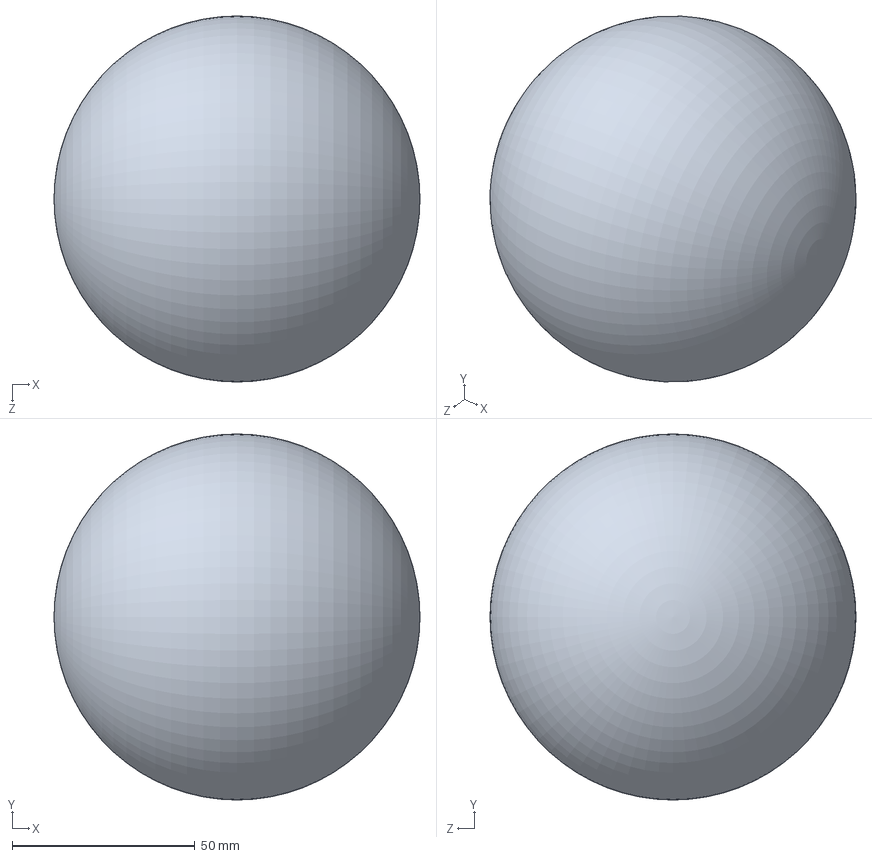
[picture p57: CAD file, 2021-06-05]
ficheiros LPI1/esfera.SLDPRT
100.0 x 100.0 x 100.0 mm
