rafaelandrepedro/LPI2-PI-Solar-Tracker/(list of files, cad)

Other CAD files:
modelo novo (com encoder)/tampa (2).SLDPRT
ficheiros LPI1/Documentação auxiliar/Solid Works/Part3.SLDPRT
modelo novo (com encoder)/part1_model1a.SLDPRT
modelo novo (com encoder)/part3_model1d.SLDPRT
ficheiros LPI1/suporte2.SLDPRT
ficheiros LPI1/Part1.SLDPRT
ficheiros LPI1/Documentação auxiliar/Solid Works/PainelSolar.SLDPRT
ficheiros LPI1/PainelSolar.SLDPRT
