rafaelandrepedro/LPI2-PI-Solar-Tracker/(list of files, drawings)

Other design files:
ficheiros LPI1/Documentação auxiliar/PADs/LPI.pcb
