rafaelandrepedro/LPI2-PI-Solar-Tracker/LPI2 Projeto Integrador/Core/Src/main.c

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
/* Includes ------------------------------------------------------------------*/
#include "main.h"
#include "adc.h"
#include "tim.h"
#include "usart.h"
#include "gpio.h"

/* USER CODE BEGIN Includes */
#include "pwm.h"
#include "encoder.h"
#include "control.h"
#include "parser.h"

/* USER CODE END Includes */

/* USER CODE BEGIN PD */

	//encoder motor horizontal
	GPIO_Port CLK={GPIOG_BASE, GPIO_PIN_9};
	GPIO_Port DT={GPIOE_BASE, GPIO_PIN_8};
	Encoder_t encoder;

/* USER CODE END PD */


/* USER CODE BEGIN PV */
char command[128];
/* USER CODE END PV */

void SystemClock_Config(void);
/**
  * @brief  The application entry point.
  * @retval int
  */
int main(void)
{
  /* MCU Configuration--------------------------------------------------------*/

  /* Reset of all peripherals, Initializes the Flash interface and the Systick. */
  HAL_Init();

  /* Configure the system clock */
  SystemClock_Config();

  /* Initialize all configured peripherals */
  MX_GPIO_Init();
  MX_ADC1_Init();
  MX_TIM6_Init();
  MX_TIM1_Init();
  MX_TIM10_Init();
  MX_USART3_UART_Init();
  MX_USART2_UART_Init();
  /* USER CODE BEGIN 2 */
	init_UART2();
  /* USER CODE END 2 */

  /* Infinite loop */
  /* USER CODE BEGIN WHILE */
	//encoder motor horizontal
	encoderInit(&encoder, CLK, DT, 1920*2);
	
	//sensores LDR																											pinos de configuração do ADC
	ADC_Port sensorCima={&hadc1, ADC_CHANNEL_0};
	ADC_Port sensorBaixo={&hadc1, ADC_CHANNEL_12};
	ADC_Port sensorEsq={&hadc1, ADC_CHANNEL_9};
	ADC_Port sensorDir={&hadc1, ADC_CHANNEL_6};
	
	//motores
	PWM_Port MV={&htim1, TIM_CHANNEL_4};
	PWM_Port MH={&htim1, TIM_CHANNEL_3};
	
	GPIO_Port refMV={GPIOE_BASE, GPIO_PIN_15};
	GPIO_Port refMH={GPIOE_BASE, GPIO_PIN_0};
	
	PWM_Bus motorVertical={MV, refMV};
	PWM_Bus motorHorizontal={MH, refMH};
  while (1)
  {
		#define LIMITE_SUPERIOR_LUZ 600
		#define LIMITE_INFERIOR_LUZ 100
		#define LIMITE_VELOCIDADE_MAXIMA 350
		
		#define AUTOMATIC 1
		
		#define NOITE 4000
		
		volatile uint32_t valor[4];		
		
		moduloBluetooth(command); 
		//receber//
		if(receve_flag){
		receve_flag = 0;
		for (uint8_t i=0;i<(1<<7);i++){
			if(Rx_Buffer[i]=='\0')
				break;
			command[i] = Rx_Buffer[i];
		}
		//parsing (dentro: execução, transmissão)//
		parser(command, motorVertical, motorHorizontal);
		//HAL_GPIO_TogglePin(GPIOB, GPIO_PIN_14);
		}

		if(control()==AUTOMATIC){
			onOffControl(sensorBaixo, sensorCima, sensorEsq, sensorDir, motorHorizontal, motorVertical,LIMITE_INFERIOR_LUZ, LIMITE_SUPERIOR_LUZ);
		}
		
		if(averageLight(sensorBaixo, sensorCima, sensorEsq, sensorDir)>NOITE){
			resetControl(encoder, motorHorizontal, LIMITE_INFERIOR_LUZ);
		}
    /* USER CODE END WHILE */

    /* USER CODE BEGIN 3 */
  }
  /* USER CODE END 3 */
}

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
/* USER CODE BEGIN 4 */





void HAL_GPIO_EXTI_Callback(uint16_t GPIO_Pin){
		if(GPIO_Pin == GPIO_PIN_9){
			updatePosition(&encoder);
		}
}


/* USER CODE END 4 */
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
