rafaelandrepedro/LPI2-PI-Solar-Tracker/LPI2 Projeto Integrador/Core/Inc/usart.h

/**
  ******************************************************************************
  * @file    usart.h
  * @brief   This file contains all the function prototypes for
  *          the usart.c file
  ******************************************************************************
  * @attention
  *
  * <h2><center>&copy; Copyright (c) 2021 STMicroelectronics.
  * All rights reserved.</center></h2>
  *
  * This software component is licensed by ST under BSD 3-Clause license,
  * the "License"; You may not use this file except in compliance with the
  * License. You may obtain a copy of the License at:
  *                        opensource.org/licenses/BSD-3-Clause
  *
  ******************************************************************************
  */
/* Define to prevent recursive inclusion -------------------------------------*/
#ifndef __USART_H__
#define __USART_H__

#ifdef __cplusplus
extern "C" {
#endif

/* Includes ------------------------------------------------------------------*/
#include "main.h"

extern UART_HandleTypeDef huart2;
extern UART_HandleTypeDef huart3;

/* USER CODE BEGIN Private defines */
extern uint8_t Rx_Buffer[128];
extern int receve_flag;
/* USER CODE END Private defines */

void MX_USART2_UART_Init(void);
void MX_USART3_UART_Init(void);

/* USER CODE BEGIN Prototypes */
void init_UART3(void);
void init_UART2(void);
void HAL_UART_RxCpltCallback(UART_HandleTypeDef* huart);
/**
  * @brief  Retrieves bytes from the uart3
  * @param	message return char array
	* @retval	byte read
  */
void moduloBluetooth(char* message);
/* USER CODE END Prototypes */

#ifdef __cplusplus
}
#endif

#endif /* __USART_H__ */

/************************ (C) COPYRIGHT STMicroelectronics *****END OF FILE****/
