rafaelandrepedro/LPI2-PI-Solar-Tracker/(commit log)

2021-05-11 Revert "."
    This reverts commit 714cf43664dc54ebc4f6c49a4020f495a0b8ba02.
    [LPI2 Projeto Integrador.ioc, adc.c, encoder.c, main.c]
2026-03-17 Relatorio preliminar de projeto (fase 0)
